w1zard999/Gyrobot/docs/SESSION-CONTEXT-2026-09-28.md

# Контекст сессии 2026-09-28 — схема Tumbller (для продолжения)

Читать вместе с STATUS.md (раздел «Сессия 2026-09-28»).

## Состояние
- Скетч: `firmware/gyrobot_tumbller/gyrobot_tumbller.ino` — стоит, ездит W/S,
  поворачивает A/D по кругу. Все подобранные значения — дефолты в прошивке.
- `firmware/gyrobot_mov` — старый, для отката (не менялся).
- Плата прошита коммитом 835385b (все дефолты в коде = в плате).

## Как работать
- Прошивка: вынуть HC-05, USB → COM10,
  `arduino-cli upload -p COM10 -b arduino:avr:nano firmware/gyrobot_tumbller`.
- После включения: положить на бок, ждать рывка колёс (калибровка ~15–20 с).
- Живые параметры по BT: `python tools/talk.py --port COM13 --boot 0.5 --cmds "kp 20"`
  (wasd.bat при этом закрыт — один порт). BT-порт не ресетит плату.
- Логи езды: `tools/logs/wasd-*.log`, разбор поворотов — `python tools/turnstat.py tools/logs/<лог>`.

## Что можно улучшить дальше
- Лёгкая тряска стоя (±0.6°) — kd/dba подобраны, дальше только механика.
- Хранить параметры в EEPROM (сейчас только дефолты в коде).
