w1zard999/Gyrobot/docs/research/Балансирующий робот Arduino эталон.md

# Возьмите Tumbller за эталон, перестаньте изобретать

За эталон стоит взять **прошивку Elegoo Tumbller**: Arduino Nano, TB6612, 2S 7,4 В, прерывание MsTimer2 каждые 5 мс, шкала ШИМ ±255 и однобуквенные команды по Bluetooth. Железо у неё почти совпадает с нашим, а алгоритм тот же, что у Keyestudio, Yahboom, Osoyoo и у китайской методики 平衡小车之家. Регулятор состоит из трёх контуров, выходы которых просто складываются: PD по углу с D-членом от гироскопа каждые 5 мс, PI по сумме энкодеров каждые 40 мс (его «интеграл» на деле означает положение колёс) и поворот через дифференциальную добавку с демпфированием по гироскопу Z. Езду никто не делает сырым ШИМ. Все задают её сдвигом цели внутри интеграла скоростного контура. Дрейф нуля никто не лечит адаптивной уставкой. Ноль угла фиксирован, а смещение центра масс выбирает тот же энкодерный интеграл. Три проблемы нашей прошивки (дрожь, уползающий ноль после повторного взвода, рывок при W/S) растут из двух отклонений от этого шаблона: «адаптивный ноль» играет роль второго интегратора на ту же ошибку, а ШИМ, добавленный в обход угла, угловой PID воспринимает как возмущение. Balanduino остаётся лучшим DIY-образцом с каскадом «скорость → целевой угол», и математически это та же схема. Но его константы привязаны к драйверам VNH5180 на 20 кГц, выходу в процентах и циклу без фиксированного периода, поэтому переносить их дороже. В конце отчёта дана готовая структура кода и стартовые коэффициенты, пересчитанные под 495 имп/об, колесо 63 мм и ШИМ ±255. Все пересчитанные числа там помечены как оценки.

## Все четыре набора прошиты одним трёхконтурным шаблоном

Исходники Tumbller, Keyestudio KS0193, Yahboom BST-ABC и Osoyoo были прочитаны напрямую, и устроены они одинаково. В ISR на 5 мс считается **угловой PD в градусах и °/с**. Раз в 8 тиков (40 мс; у Osoyoo раз в 10) работает **PI по сумме импульсов обоих колёс**: скорость проходит через фильтр 0,7/0,3, интеграл ограничен ±3000 (±3550 у Keyestudio). Результат складывается в `PWM = ±угол − скорость ∓ поворот` и обрезается до ±255 ([Elegoo BalanceCar.h](https://github.com/elegooofficial/ELEGOO-TumbllerV1.1-Self-Balancing-Car-Tutorial); [Keyestudio](https://github.com/keyestudio/KS0193-Self-balancing-Car-Kit); [Yahboom](https://github.com/YahboomTechnology/Arduino-Balance-Car)). Osoyoo ничем не отличается от Yahboom: те же вызовы `speedpiout / turnspin` и тот же протокол `$...#` ([Osoyoo](https://osoyoo.com/wp-content/uploads/2018/03/osoyoo_abc.zip)). Оригинал 平衡小车之家 на STM32 делает то же самое на своей шкале: `Moto1 = Balance + Velocity − Turn`, `Moto2 = Balance + Velocity + Turn`, угол каждые 5 мс, управление каждые 10 мс ([minibalance control.c](https://github.com/zycczy/minibalance/blob/master/MiniBalance/CONTROL/control.c)). Arduino-порт этого кода от jfboy использует MsTimer2, 5 мс для угла, 40 мс для скорости и 20 мс для поворота ([jfboy balance_car_2.0.ino](https://github.com/jfboy/BalanceCar/blob/master/balance_car_2.0.ino)).

Скоростной контур Tumbller стоит привести дословно, потому что именно его мы и берём:

```c
if (++speed_control_period_count >= 8) {           // 40 мс
  double car_speed = (enc_left + enc_right) * 0.5;  // среднее по колёсам, имп/40 мс
  enc_left = enc_right = 0;
  speed_filter = speed_filter_old * 0.7 + car_speed * 0.3;
  speed_filter_old = speed_filter;
  car_speed_integeral += speed_filter;
  car_speed_integeral += -setting_car_speed;         // команда езды — внутрь интеграла
  car_speed_integeral = constrain(car_speed_integeral, -3000, 3000);
  speed_control_output = -kp_speed * speed_filter - ki_speed * car_speed_integeral;
  rotation_control_output = setting_turn_speed + kd_turn * Gyro_z;
}
pwm_left  = balance_control_output - speed_control_output - rotation_control_output;
pwm_right = balance_control_output - speed_control_output + rotation_control_output;
```

Код взят из [Elegoo BalanceCar.h](https://github.com/elegooofficial/ELEGOO-TumbllerV1.1-Self-Balancing-Car-Tutorial). После раскрытия знаков получается `PWM = kp·θ + kd·ω + kp_s·v + ki_s·Σ(v − v_set)`. **Скоростные члены входят с тем же знаком, что и член наклона.** Это знаменитая «положительная обратная связь по скорости». В исходнике STM32 прямо написано, что скоростная обратная связь положительная: чтобы замедлиться на скорости, машинка сначала должна поехать ещё быстрее ([control.c](https://github.com/zycczy/minibalance/blob/master/MiniBalance/CONTROL/control.c)). На Zhihu это объясняют через каскад: выход скоростного контура служит целевым углом для углового, и после подстановки одного уравнения в другое внешний контур приобретает «положительный» знак ([知乎 p/206522126](https://zhuanlan.zhihu.com/p/206522126)). Значит, китайская параллельная схема и каскад Balanduino, где скорость задаёт целевой угол, — одно и то же. Параллельная форма просто вынесла деление на Kp угла в сами коэффициенты.

Коэффициенты наборов выражены в одних единицах: ШИМ на градус и ШИМ на °/с при шкале ±255.

| Набор | kp угла | kd угла | kp скорости | ki скорости | поворот | питание |
|---|---|---|---|---|---|---|
| Tumbller | 55 | 0,75 | 10 | 0,26 | kd_turn 0,5 (kp_turn 2,5 не используется) | 2S 7,4 В, 1:30 |
| Keyestudio | 34 | 0,62 | 3,6 | 0,080 | kp 24, kd 0,08 | 3×18650, 12 В |
| Yahboom | 38 | 0,58 | 3,8 | 0,11 | kp 28, kd 0,29 | 3×18650 |
| Osoyoo | 40 | 0,6 | 5,2 | 0,25 | kp 23, kd 0,3 | 3×18650 |

Источники таблицы: [Elegoo](https://github.com/elegooofficial/ELEGOO-TumbllerV1.1-Self-Balancing-Car-Tutorial), [Keyestudio](https://github.com/keyestudio/KS0193-Self-balancing-Car-Kit), [Yahboom](https://github.com/YahboomTechnology/Arduino-Balance-Car), [Osoyoo](https://osoyoo.com/wp-content/uploads/2018/03/osoyoo_abc.zip). По железу **Tumbller ближе всех к нам**: два ICR18650, моторы 1:30 с датчиком Холла на 22 импульса за оборот мотора (660 на оборот колеса), колесо около 67 мм. Эти данные взяты из стороннего блога и только из поисковых сниппетов ([Tom Wilson, Medium](https://medium.com/@tomw3115/programming-the-elegoo-tumbller-self-balancing-robot-part-2-e9ab09c6bea2)). Остальные три набора работают от 12 В. У Tumbller есть и слабые места, которые мы не копируем. Направление энкодера он берёт из знака последнего ШИМ, а не из квадратуры. В D-член подаёт сырой гироскоп с зашитым смещением 128,1 LSB, а не скорость, очищенную фильтром Калмана от смещения. `Gyro_z = -gz / 131` у него считается целочисленным делением. Наконец, в скоростном цикле нет никакой рампы ([Elegoo BalanceCar.h / KalmanFilter.cpp](https://github.com/elegooofficial/ELEGOO-TumbllerV1.1-Self-Balancing-Car-Tutorial)). Keyestudio берёт для D-члена очищенную скорость `angle_speed = gyro_m − q_bias`, и это правильный вариант ([Keyestudio](https://github.com/keyestudio/KS0193-Self-balancing-Car-Kit)).

## Езда идёт через интеграл положения, а не через сырой ШИМ

**Ни один проверенный проект не добавляет «ШИМ езды» в обход углового контура.** Tumbller каждые 40 мс вычитает `setting_car_speed` из интеграла: 80 в режиме Bluetooth, 40 по умолчанию, 20 в режиме следования. Поэтому в установившемся режиме отфильтрованная скорость равна этой цели в импульсах за 40 мс ([Elegoo Tumbller.ino](https://github.com/elegooofficial/ELEGOO-TumbllerV1.1-Self-Balancing-Car-Tutorial)). Для колеса Tumbller 80 имп/40 мс соответствуют примерно 0,6 м/с. Keyestudio и Yahboom на каждом тике прибавляют к `positions` ±250 (в другой ревизии Yahboom ±700) ([Keyestudio](https://github.com/keyestudio/KS0193-Self-balancing-Car-Kit); [Yahboom mirror](https://github.com/GaloisInc/lean4-balance-car/blob/main/ArduinoBalanceCar/ArduinoBalanceCar.ino)). Оригинал STM32 делает `Encoder_Integral -= Movement`. Максимальную скорость там ограничивает ограничение интеграла, а комментарий в jfboy так и называет его: «积分限,控制最高速度» ([control.c](https://github.com/zycczy/minibalance/blob/master/MiniBalance/CONTROL/control.c); [jfboy](https://github.com/jfboy/BalanceCar/blob/master/balance_car_2.0.ino)). Разбор на CSDN объясняет, почему цель задают через интеграл, а не через ошибку скорости. Прямая уставка скорости слишком сильно мешает удержанию вертикали и на практике работает нестабильно. Смещение положения меняется медленно и на вертикаль почти не влияет. Итоговый вывод автора: «控制速度的本质就是改变倾角», то есть управлять скоростью значит менять наклон ([CSDN 54572569](https://blog.csdn.net/zhaoyuaiweide/article/details/54572569)).

Этим объясняется наш рывок. Если прибавить к выходу ШИМ, не сдвинув цель, угловой PID увидит возмущение и сначала погасит его толчком в обратную сторону, и только потом робот наклонится. В схеме с интегралом порядок обратный и физически правильный. Интеграл уходит в минус, колёса на мгновение откатываются назад, корпус наклоняется вперёд, и дальше угловой контур сам разгоняет робот. Так ведёт себя неминимально-фазовая система. Balanduino добивается того же явным путём. Команда пульта сдвигает уставку угла не больше чем на `controlAngleLimit = 7°`, а сама уставка меняется не быстрее чем на **1° за итерацию** (`constrain(restAngle, lastRestAngle − 1, lastRestAngle + 1)`) ([Motor.ino](https://github.com/TKJElectronics/Balanduino/blob/master/Firmware/Balanduino/Motor.ino); [EEPROM.ino](https://github.com/TKJElectronics/Balanduino/blob/master/Firmware/Balanduino/EEPROM.ino)). У Tumbller рампы нет, цель меняется ступенькой. Сглаживает её только фильтр 0,7/0,3 и сам интегратор. Поэтому рампу цели мы добавим сами, по примеру Balanduino.

Поворот везде сделан дифференциальной добавкой: одному колесу она прибавляется, у другого вычитается. У Tumbller это `setting_turn_speed + kd_turn·Gyro_z`, где setting равен ±80 ШИМ в режиме Bluetooth, а kd_turn 0,5 ([Elegoo](https://github.com/elegooofficial/ELEGOO-TumbllerV1.1-Self-Balancing-Car-Tutorial)). Если переписать выражение как `kd_turn·(ω_цель − ω_z)`, видно, что это П-регулятор угловой скорости рыскания с целью 80/0,5 = 160 °/с. Такая запись удобнее для нас. Keyestudio, Yahboom и STM32 не прыгают сразу на полную цель поворота. Пока клавиша держится, они наращивают её с шагом, который зависит от текущей скорости (`Turn_Convert = 50/|сумма энкодеров|`, от 0,6 до 3), а при отпускании сбрасывают в ноль ([control.c turn()](https://github.com/zycczy/minibalance/blob/master/MiniBalance/CONTROL/control.c); [Yahboom](https://github.com/YahboomTechnology/Arduino-Balance-Car)). В режиме Bluetooth Tumbller разрешает ехать и поворачивать одновременно. STM32 такое сочетание запрещает. Автоматического отпускания команд по таймауту нет ни в одном из кодов: Yahboom полагается на явный символ «стоп», у Tumbller это `s` ([Yahboom mirror](https://github.com/GaloisInc/lean4-balance-car/blob/main/ArduinoBalanceCar/ArduinoBalanceCar.ino); [Elegoo Command.h](https://github.com/elegooofficial/ELEGOO-TumbllerV1.1-Self-Balancing-Car-Tutorial)). Наш ПК-клиент при отпускании клавиши просто перестаёт слать буквы, поэтому таймаут придётся добавить самим.

## Дрейф нуля убирает энкодерный интеграл, а не адаптивная уставка

Во всех наборах **ноль угла — константа**: `angle_zero = 0` у Tumbller, `angle0 = 0` у Yahboom и Osoyoo, 0 или 1 у Keyestudio. Во время работы его никто не подстраивает. Исключение одно: скетч 12 Keyestudio позволяет задать ноль вручную с телефона ([Elegoo](https://github.com/elegooofficial/ELEGOO-TumbllerV1.1-Self-Balancing-Car-Tutorial); [Keyestudio](https://github.com/keyestudio/KS0193-Self-balancing-Car-Kit)). Смещение центра масс выбирает интеграл скоростного контура. В установившемся режиме робот стоит под таким наклоном, при котором `Kp·(θ − ноль) + Ki·x = 0`. Ошибка нуля на Δ градусов лишь сдвигает точку стоянки на `Kp·Δ/Ki` импульсов, для STM32 это 300·1/0,4 = 750. Это наш вывод из формул [control.c](https://github.com/zycczy/minibalance/blob/master/MiniBalance/CONTROL/control.c). В оригинале STM32 есть даже режим «斜坡悬停» (удержание на склоне), где это сделано явно: `Zhongzhi = −Encoder/10 − Encoder_Integral/300`. Уставка там движется **по состоянию энкодеров, а не по выходу PID** ([control.c](https://github.com/zycczy/minibalance/blob/master/MiniBalance/CONTROL/control.c)). Balanduino поступает так же. В режиме стоянки уставка угла корректируется по ошибке положения колёс по четырём зонам и по их скорости, ограничена ±10° от номинала, а точка удержания запоминается, только когда `|wheelVelocity| ≤ 40` ([Motor.ino](https://github.com/TKJElectronics/Balanduino/blob/master/Firmware/Balanduino/Motor.ino); [Balanduino.ino](https://github.com/TKJElectronics/Balanduino/blob/master/Firmware/Balanduino/Balanduino.ino)).

«Адаптивный ноль по выходу PID» пришёл из робота YABR на шаговых моторах. Там уставка сдвигается на ±0,0015 за цикл 4 мс, и только при отпущенном пульте ([yabr](https://github.com/siredmar/yabr/blob/master/Balancing_robot_ownPID/Balancing_robot_ownPID.ino)). У шаговика выход PID и есть скорость колёс, поэтому средний ненулевой выход действительно значит «уезжаю». У DC-мотора выход означает напряжение, то есть момент. Средний ненулевой ШИМ может давать трение, мёртвая зона, разница моторов или просевшая батарея, так что адаптация исправляет не ту причину. У нас она вдобавок образует второй интегратор на ту же ошибку, не согласованный с первым, и накопленный сдвиг сохраняется после повторного взвода. Всё это наш вывод, но он точно описывает наблюдаемые симптомы. Прямого сравнения двух подходов на DC-роботах в источниках найти не удалось.

Защита от падения во всех кодах одинакова: при большом наклоне моторы отключаются и сбрасываются интеграторы. Tumbller отключается за пределами ±22°, в STOP обнуляет `car_speed_integeral` и цель скорости, а при старте ждёт 2 с, проверяет, что угол в пределах ±22°, и снова всё обнуляет ([Elegoo BalanceCar.h / Tumbller.ino](https://github.com/elegooofficial/ELEGOO-TumbllerV1.1-Self-Balancing-Car-Tutorial)). Порог у Yahboom ±30°, у STM32 ±40° ([Yahboom](https://github.com/YahboomTechnology/Arduino-Balance-Car); [control.c](https://github.com/zycczy/minibalance/blob/master/MiniBalance/CONTROL/control.c)). STM32 обнуляет интеграл всякий раз, когда моторы выключены: «电机关闭后清除积分». В нём же есть детектор подъёма робота в три этапа (покой, всплеск ускорения по Z у вертикали, разгон колёс) и детектор постановки на пол. Balanduino через `stopAndReset()` обнуляет iTerm и lastError, запоминает `targetPosition` и возвращает уставку к номиналу ([Motor.ino](https://github.com/TKJElectronics/Balanduino/blob/master/Firmware/Balanduino/Motor.ino)). Мягкого старта с плавным нарастанием коэффициентов после взвода нет ни в одном источнике.

## Цикл 5 мс, гироскоп ±250 °/с и медленный внешний контур

Частота у всех близкая. Arduino-наборы и jfboy используют ISR MsTimer2 на 5 мс, который начинается с `sei()`, чтобы внутри могли срабатывать прерывания энкодеров. В этой же ISR выполняются чтение I2C, фильтр, PD и запись в моторы ([Elegoo](https://github.com/elegooofficial/ELEGOO-TumbllerV1.1-Self-Balancing-Car-Tutorial); [jfboy](https://github.com/jfboy/BalanceCar/blob/master/balance_car_2.0.ino)). YABR держит жёсткие 4 мс по `micros()` и настраивает MPU на ±250 °/с с DLPF 0x03 ([yabr](https://github.com/siredmar/yabr/blob/master/Balancing_robot_ownPID/Balancing_robot_ownPID.ino)). У Balanduino та же настройка: ±250 °/с, `0x03 // 44 Hz Acc filtering, 42 Hz Gyro filtering`. Цикл у него работает без фиксированного периода с измерением dt, а смещение гироскопа калибруется на старте по 25 выборкам с проверкой неподвижности ([Balanduino.ino](https://github.com/TKJElectronics/Balanduino/blob/master/Firmware/Balanduino/Balanduino.ino); [Tools.ino](https://github.com/TKJElectronics/Balanduino/blob/master/Firmware/Balanduino/Tools.ino)). Сами наборы DLPF не настраивают и полагаются на значения библиотеки по умолчанию. Задержка гироскопа при DLPF 3 составляет около 4,8 мс, при DLPF 2 около 2,8 мс, при DLPF 4 около 8,3 мс. Эти цифры взяты из карты регистров MPU-6000/6050, регистр 26, и их нужно сверить с PDF ([Register Map](https://invensense.tdk.com/wp-content/uploads/2015/02/MPU-6000-Register-Map1.pdf)).

Тип фильтра вторичен. Tumbller, Keyestudio и Yahboom используют один и тот же скалярный фильтр Калмана (`Q_angle 0.001, Q_gyro 0.005, R_angle 0.5, dt 0.005`, угол `atan2(ay, az)`). В STM32 можно выбрать DMP, Калмана или комплементарный фильтр с `K1 = 0.02`, и авторы пишут, что «все три хорошо настроены» ([filter.c](https://github.com/zycczy/minibalance/blob/master/MiniBalance/filter/filter.c); [control.c](https://github.com/zycczy/minibalance/blob/master/MiniBalance/CONTROL/control.c)). Комплементарный фильтр с K1 = 0,02 при шаге 5 мс имеет постоянную времени около 0,25 с (наш пересчёт). Скорость фильтруется так: у Tumbller 0,7/0,3 на тик 40 мс, что по нашему расчёту даёт постоянную около 110 мс; у STM32 0,8/0,2 на тик 10 мс. Цель китайские авторы формулируют прямо: «平衡为主，其他为辅», то есть главное — удержание вертикали, остальное вторично, и скоростной контур нельзя пускать в ту же полосу частот ([知乎 p/206522126](https://zhuanlan.zhihu.com/p/206522126)). B-robot идёт дальше и вычитает из скорости колёс вклад качания корпуса, `estimated_speed = −actual_robot_speed + angular_velocity`, после чего фильтрует 0,9/0,1 ([BROBOT_EVO2.ino](https://github.com/jjrobots/B-ROBOT_EVO2/blob/master/Arduino/BROBOT_EVO2/BROBOT_EVO2.ino)).

Две особенности нашего робота делают тайминг строже, чем у наборов. Первая — низкий центр масс. Неустойчивый полюс 19 рад/с соответствует эффективной длине маятника около 27 мм. Проверенные проекты, наоборот, поднимают массу: в EduBal батарею «purposely placed high above the ground … to raise the center of mass» ([arXiv 2005.09304](https://arxiv.org/pdf/2005.09304)). Для маятника темп расхождения равен √(g/ℓ) ([Wikipedia](https://en.wikipedia.org/wiki/Inverted_pendulum)). По нашей оценке, если поднять ℓ до 60–100 мм, полюс снизится до 10–13 рад/с, а время удвоения наклона вырастет с 36 до 54–70 мс. Вторая — люфт редуктора. EduBal прямо называет его главной причиной остаточных колебаний и ради этого вводит внутренний PI по скорости колеса ([arXiv 2005.09304](https://arxiv.org/pdf/2005.09304)). Против люфта и мёртвой зоны помогают меньший Kp, более сильный D-член от гироскопа, а также небольшая компенсация мёртвой зоны (MIN_ABS_SPEED 30 у Franko) или зона нечувствительности выхода ±5 у YABR ([Franko](https://github.com/lukagabric/Franko); [yabr](https://github.com/siredmar/yabr/blob/master/Balancing_robot_ownPID/Balancing_robot_ownPID.ino)). В Balanduino компенсации мёртвой зоны нет вообще ([Motor.ino](https://github.com/TKJElectronics/Balanduino/blob/master/Firmware/Balanduino/Motor.ino)).

## Адаптация: Tumbller на нашем Nano, шаг за шагом

### Почему Tumbller, а не Balanduino или STM32-оригинал

Tumbller выигрывает, потому что совпадает с нами по всему, что определяет масштаб коэффициентов. Это тот же ATmega328P, тот же TB6612, те же 2S 7,4 В, та же шкала ±255, тот же MsTimer2 на Timer2 (он у нас свободен) и тот же однобуквенный протокол. Его kp и kd в ШИМ/° и ШИМ/(°/с) переносятся без смены единиц. Balanduino — хороший и открытый образец с каскадом через угол, но у него выход в процентах, ШИМ 20 кГц на VNH5180, цикл без фиксированного периода и восемь зонных констант положения, привязанных к 928 имп/об ([Balanduino.h](https://github.com/TKJElectronics/Balanduino/blob/master/Firmware/Balanduino/Balanduino.h)). Каждую пришлось бы пересчитывать. STM32-оригинал работает на шкале 8400 с сырым гироскопом ±2000 °/с. Его стоит брать как справочник по методике настройки, а не как код для переноса. Из остальных источников мы берём четыре доработки. От Keyestudio и Balanduino — очищенную от смещения скорость гироскопа в D-член. От Balanduino — рампу цели движения. От STM32 — сброс интеграла при любом отключении моторов. Своё добавляем квадратурное направление энкодера и таймаут клавиш. Адаптивный ноль, фазовый гейт и инжекцию сырого ШИМ из текущей прошивки нужно **удалить полностью**.

### Структура цикла и формулы со знаками

Знаки условимся считать так. θ > 0 означает наклон вперёд, ω = dθ/dt в °/с. ШИМ > 0 крутит колесо вперёд. Импульсы энкодеров со знаками esA = +1 и esB = −1 положительны при движении вперёд. Скорость рыскания r > 0 означает поворот влево, против часовой стрелки при взгляде сверху. При оси Z вверх это знак gz, но его нужно проверить на шаге 8 ниже. Период 5 мс задаёт MsTimer2. Надёжнее, чтобы ISR только ставила флаг, а весь расчёт шёл в `loop()` по этому флагу. Дело в том, что Wire с таймаутом `setWireTimeout(25000, true)`, спасающий нашу шину от помех моторов, и Serial в ISR ведут себя хуже. Tumbller считает прямо в ISR после `sei()`. Это рабочий вариант, но в нём таймаут I2C на 25 мс ломает период. Отход от эталона здесь наш и сознательный.

```c
// ---- 5 мс тик ----
void controlTick() {
  if (!mpuRead()) return;                              // 14 байт с 0x3B, timeout как сейчас
  float rate   = (GyX - gxOff) / 131.0f;               // °/с, gxOff калибруется на старте
  float yawR   = (GyZ - gzOff) / 131.0f;               // °/с, знак проверить (шаг 8)
  float accAng = atan2(AcY - ABY, AcZ - ABZ) * 57.296f; // как в текущем imu.h
  angle = 0.98f * (angle + rate * 0.005f) + 0.02f * accAng;   // K1=0.02 (minibalance)

  if (!armed) { motorsCoast(); tryArm(); return; }
  if (fabs(angle - ANGLE_ZERO) > FALL_DEG) { disarm(); return; }

  float balance = KP * (angle - ANGLE_ZERO) + KD * rate;      // PD, D от гироскопа

  if (++spdCnt >= 8) {                                  // 40 мс
    spdCnt = 0;
    noInterrupts(); int cL = encL; int cR = encR; encL = encR = 0; interrupts();
    float v = (cL + cR) * 0.5f;                         // имп/40 мс, среднее колёс, + вперёд
    vF = 0.7f * vF + 0.3f * v;                          // фильтр Tumbller
    updateKeysAndRamps();                               // moveSet, turnSet (см. ниже)
    posI += vF - moveSet;                               // интеграл = положение минус цель
    posI = constrain(posI, -I_LIM, I_LIM);
    speedOut = KP_S * vF + KI_S * posI;                 // тот же знак, что у balance
  }
  float turn = KD_T * (turnSet - yawR);                 // П по скорости рыскания
  float uL = balance + speedOut - turn;                 // левое = мотор A
  float uR = balance + speedOut + turn;                 // turn>0 → правое быстрее → влево
  motorOut(A, uL, DB_A);  motorOut(B, uR, DB_B);        // +sign(u)*DB, clamp ±255
}
```

`disarm()` отключает моторы (STBY = LOW или все IN в 0). `tryArm()` взводит робот, когда |θ − ANGLE_ZERO| < 5° непрерывно 300 мс. И взвод, и падение обнуляют одно и то же: `posI`, `vF`, `speedOut`, `moveSet`, `turnSet`, счётчики энкодеров и состояние клавиш. `ANGLE_ZERO` во время работы **не меняется никогда**. Прерывания энкодеров остаются как есть: RISING на A, направление по B в ISR. Это настоящая квадратура, в отличие от Tumbller, где направление угадывается по знаку ШИМ именно там, где балансирующий робот проводит всё время, около нуля. При желании можно считать CHANGE на A и определять направление по равенству A и B, как в jfboy «二倍频» ([jfboy](https://github.com/jfboy/BalanceCar/blob/master/balance_car_2.0.ino)). Это даст 990 имп/об и вдвое меньший шум квантования скорости, но тогда KP_S, KI_S и MOVE нужно поделить на 2, а I_LIM умножить на 2.

### WASD: цели, рампы и таймаут

В `loop()` каждый принятый байт `w/s/a/d` обновляет свою метку `tW/tS/tA/tD = millis()`. Клиент шлёт буквы с частотой 10 Гц, поэтому клавиша считается нажатой, пока её метка моложе **250 мс**, то есть 2,5 периода. Раз в 40 мс `updateKeysAndRamps()` вычисляет направление `fwd = (W нажата) − (S нажата)` и цель `moveTgt = fwd·MOVE`. Затем `moveSet` подтягивается к этой цели не быстрее чем на 2 имп/40 мс при разгоне и на 3 имп/40 мс при торможении. Цель поворота `turnTgt = ((A) − (D))·YAW_MAX` в °/с. `turnSet` растёт к ней на 15 °/с за тик, а при отпускании клавиши, как в STM32 и Yahboom, сразу сбрасывается в 0. Дальше робот тормозит вращение сам через член `−KD_T·yawR`. Езда и поворот складываются, как в режиме Bluetooth у Tumbller. Рампа выбрана из физики, это наш расчёт. Каждый тик прибавляет к цели 2 имп/40 мс = 50 имп/с ≈ 0,02 м/с. За 40 мс это ускорение около 0,5 м/с², и оно ведёт к установившемуся наклону atan(0,5/9,81) ≈ 3°. Это в пределах 7°, которые Balanduino разрешает пульту. Если после отпускания W робот катится дальше слишком долго, можно добавить трюк из jfboy: при нулевой команде стравливать интеграл к нулю на 200 за тик, если |интеграл| > 300. Масштаб этих чисел нужно подобрать заново ([jfboy](https://github.com/jfboy/BalanceCar/blob/master/balance_car_2.0.ino)).

### Стартовые коэффициенты, пересчитанные под наше железо

Пересчёт основан на отношении разрешений. У Tumbller 660 имп на π·67 мм ≈ 3,14 имп/мм, у нас 495 на π·63 мм ≈ 2,50 имп/мм, отношение 0,80. Скоростные коэффициенты привязаны к импульсам, поэтому их нужно умножить на 1,25, а ограничение интеграла и цель движения — на 0,80. Шкала ШИМ и периоды совпадают. Отношение kp_s/kp угла имеет физический смысл: это «градусы целевого наклона на единицу скорости». Нужный для ускорения наклон, a = g·tanθ, не зависит от высоты центра масс, поэтому переносить надо именно это отношение, а не абсолютное значение kp_s. У Tumbller оно равно 10/55 ≈ 2,3° на 100 мм/с и 0,26/55 ≈ 1,5° на 100 мм ошибки положения. В наших импульсах получается **KP_S ≈ 0,228·KP** и **KI_S ≈ 0,0059·KP**. Для сверки: в Tumbller ki/kp скорости равно 1/38 при тике 40 мс, а китайское правило Ki = Kp/200 при тике 10 мс в реальном времени соответствует 1/50 при 40 мс, то есть величине того же порядка ([CSDN 105153978](https://blog.csdn.net/best_xiaolong/article/details/105153978); [minibalance main.c](https://github.com/zycczy/minibalance/blob/master/USER/main.c)).

| Параметр | Tumbller (источник) | Наш старт | Происхождение |
|---|---|---|---|
| Период угла / скорости | 5 мс / 40 мс | 5 мс / 40 мс | из источника |
| Фильтр скорости | 0,7/0,3 | 0,7/0,3 | из источника |
| Фильтр угла | Калман Q 0,001/0,005, R 0,5 | комплементарный K1 0,02 (или Калман Tumbller) | из источника (minibalance / Tumbller) |
| MPU | ±250 °/с, DLPF не задан | ±250 °/с, DLPF 0x03 (при запасе можно 0x02) | Balanduino/YABR, выбор под наш быстрый полюс |
| KP угла, ШИМ/° | 55 | начать с 20, найти предел, умножить на 0,6; ожидается 30–50 | оценка |
| KD угла, ШИМ/(°/с) | 0,75 (сырой гироскоп) | начать с 0,4; ожидается 0,7–1,2 (нужно больше D, чем у Tumbller, из-за полюса 19 рад/с) | оценка |
| KP_S, ШИМ/(имп/40 мс) | 10 | 0,228·KP → 8,0 при KP 35; 12,5 при KP 55 | пересчёт |
| KI_S, ШИМ/имп | 0,26 | 0,0059·KP → 0,21 при KP 35; 0,33 при KP 55 | пересчёт |
| I_LIM, имп | ±3000 | ±2400 | пересчёт (×0,80) |
| Цель езды MOVE, имп/40 мс | 80 (≈0,64 м/с) | 15 (≈0,15 м/с), затем до 25 (≈0,25 м/с) | пересчёт и выбор: 1 имп/40 мс ≈ 10 мм/с |
| Рампа MOVE | нет | +2 / −3 имп/40 мс за тик | наше, по образцу лимита Balanduino 1°/итерацию |
| Поворот | 80 ШИМ + 0,5·Gyro_z → ≈160 °/с | KD_T 0,5, YAW_MAX 90 °/с, рампа 15 °/с за 40 мс | пересчёт и выбор |
| Отключение при падении | ±22° | ±25° | выбор (у наборов 22–40°) |
| Взвод | ждёт 2 с, угол в пределах ±22° | |θ − ANGLE_ZERO| < 5° в течение 300 мс, полный сброс | наше |
| Мёртвая зона | нет | DB_A 12, DB_B 9 (≈75% от измеренных 16/12) | оценка |
| Таймаут клавиши | нет (явный `s`) | 250 мс | наше |

Потолок скорости на 7,4 В мы оценили пропорционально: 210 об/мин при 6 В дают около 260 об/мин без нагрузки, то есть примерно 0,85 м/с. Цель Tumbller в 0,64 м/с для нас близка к насыщению, поэтому MOVE стоит начинать с 15. Оценки ki_s·I_LIM ≈ 500 ШИМ при KP 35 хватает, чтобы выбрать ошибку нуля в несколько градусов. При KP 35 каждый градус ошибки стоит около 170 импульсов, то есть примерно 7 см сдвига точки стоянки. Это тоже наш расчёт.

### Процедура проверки знаков и настройки

Порядок взят из китайской методики: 机械中值, затем полярность и величина Kp и Kd угла, умножение на 0,6, полярность и величина скоростного контура, поворот. В jfboy эти этапы оставлены в коде закомментированными строками: «только вертикаль», «вертикаль + скорость», «три контура» ([CSDN 113786386](https://blog.csdn.net/weixin_44270218/article/details/113786386); [CSDN 105153978](https://blog.csdn.net/best_xiaolong/article/details/105153978); [jfboy](https://github.com/jfboy/BalanceCar/blob/master/balance_car_2.0.ino)). Каждый шаг ниже меняет только одну величину.

| Шаг | Что включено | Действие | Правильно | Если нет |
|---|---|---|---|---|
| 0 | моторы выключены | Медленно наклонять робот рукой вперёд и назад до точки опрокидывания, записать оба угла | ANGLE_ZERO = середина между ними (пример из источника: 2° и −3° → −1°) | — |
| 1 | только моторы | Подать +60 ШИМ на A, потом на B | колесо едет вперёд, его счётчик растёт | поменять AIN1/AIN2 (BIN1/BIN2) или знак es |
| 2 | только IMU | Наклонить робот вперёд | angle растёт, rate > 0 | сменить знак atan2 или гироскопа |
| 3 | KP = 20, всё остальное 0 | Держа робот, наклонить его вперёд | колёса едут вперёд, «под падение» | сменить знак KP |
| 4 | KD = 0,4, KP = 0 | Поднять робот, быстро качнуть корпус вперёд вокруг оси | колёса крутятся вперёд, «следуют» за корпусом | сменить знак KD |
| 5 | KP и KD | Поднимать KP до крупных низкочастотных колебаний, затем KD до высокочастотного дребезга; оба умножить на 0,6 | стоит несколько секунд, потом уползает; это нормально | — |
| 6 | KP_S = 8, KI_S = 0, KP = KD = 0 | Поднять робот, провернуть одно колесо вперёд рукой | оба колеса разгоняются вперёд (положительная обратная связь) | сменить знак скоростного члена |
| 7 | все контуры, KI_S = 0,0059·KP | Поставить на пол, толкнуть | стоит на месте и возвращается на точку; мало → уезжает через 1–2 с, много → раскачка с большим наклоном | KP_S и KI_S вместе, методом бисекции |
| 8 | KD_T = 0,5 | Поднять робот, повернуть его вокруг вертикали влево | колёса создают момент против поворота | сменить знак yawR |
| 9 | всё | Нажать W | короткий откат назад, наклон вперёд, плавная езда; после отпускания остановка без раскачки | уменьшить рампу или MOVE |

Критерии для шагов 3–7 взяты из источников: [CSDN 105153978](https://blog.csdn.net/best_xiaolong/article/details/105153978), [CSDN 113786386](https://blog.csdn.net/weixin_44270218/article/details/113786386), [CSDN 54572569](https://blog.csdn.net/zhaoyuaiweide/article/details/54572569). По правилу «умножить на 0,6» китайские авторы пишут, что по инженерному опыту идеальные параметры равны максимальным, умноженным на 0,6. Сразу после этого робот стоит хуже, пока не включён скоростной контур ([CSDN 113786386](https://blog.csdn.net/weixin_44270218/article/details/113786386)). Если на шаге 5 дрожь не уходит ни при каком KD, вероятная причина — люфт при низком центре масс. Тогда в первую очередь стоит уменьшить KP и поднять батарею, а подкручивать мёртвую зону — потом.

## Conclusion

Главный вывод: проблема была не в неудачных коэффициентах, а в том, куда подаются управляющие сигналы. Оба наших изобретения, адаптивный ноль и инжекция ШИМ с фазовым гейтом, пытались сделать то, что в проверенной схеме делает одна переменная: интеграл положения колёс внутри скоростного контура. Через неё проходят и компенсация центра масс, и команда езды, и ограничение скорости. Когда все три задачи сводятся в эту переменную, из прошивки исчезают и второй интегратор, и конфликт с угловым контуром. Сброс этой переменной при взводе устраняет «уползший ноль».

Всё, что осталось подобрать, — это KP и KD угла. Они зависят от нашего быстрого полюса и люфта, поэтому из источников их не взять. Скоростные коэффициенты после этого вычисляются по отношению к KP, а не подбираются заново. Самое дешёвое усиление всей схемы механическое: подъём батареи на 5–10 см замедляет полюс примерно в 1,5–2 раза. Это даёт больше запаса, чем любая замена фильтра или частоты цикла.
