w1zard999/Gyrobot/docs/STATUS.md

# Гиробот — журнал проекта

> Актуальная инструкция — `README.md` в корне. Здесь подробная история поисков,
> замеров и настройки по сессиям; старые разделы описывают прошивки, которых
> в репозитории больше нет (gyrobot_mov, v5 — см. историю git).

Обновляется по ходу работы. Не переделывать то, что уже отмечено сделанным.

## Железо (из schema.png, EasyEDA, rev 1.0)

- MCU: Arduino Nano (ATmega328P)
- IMU: MPU-6050 (I2C)
- Драйвер моторов: TB6612FNG
- Bluetooth: HC-05 — **физически отключён**, разведён на аппаратный UART (D0/D1)
- Клеммники: JP3 = питание (батарея), JP2 = мотор A, JP1 = мотор B

## Распиновка — РЕАЛЬНАЯ, снята прозвонкой на живой плате

**schema.png НЕ соответствует собранной плате. Верить только этой таблице.**
Найдено перебором пинов с обратной связью по энкодерам (2026-09-07).

| Nano | Куда | Проверено |
|---|---|---|
| D9  | TB6612 PWMA | мотор A крутится в обе стороны |
| D7  | TB6612 AIN1 | + направление |
| D8  | TB6612 AIN2 | − направление |
| D10 | TB6612 PWMB | мотор B крутится в обе стороны |
| D5  | TB6612 BIN1 | + направление |
| D4  | TB6612 BIN2 | − направление |
| D6  | TB6612 STBY | HIGH = драйвер включён |
| A4  | MPU6050 SDA | I2C работает |
| A5  | MPU6050 SCL | I2C работает |
| D2  | энкодер A, канал A | INT0 |
| A2  | энкодер A, канал B | направление |
| D3  | энкодер B, канал A | INT1 |
| A3  | энкодер B, канал B | направление |
| D0/D1 | HC-05 TXD/RXD | модуль снят, конфликт с USB |

**Мотор A = ЛЕВОЕ колесо, мотор B = ПРАВОЕ.**
Знаки энкодеров: команда `t a +` даёт totA отрицательный → `esA = -1`, `esB = +1`.

Свободны: D11, D12, D13, A0, A1.

### Чем схема врала
Схема показывала PWMA на D4/D11, AIN1 на D5, BIN1/BIN2 на D7/D8 — всё это неверно.
Не тратить время на трассировку schema.png, она устарела относительно сборки.

### Как искать пин, если что-то снова не сойдётся
1. `io <пин> <0|1>` — ручное управление любым пином
2. Держать ШИМ-пин канала в HIGH, по очереди поднимать пины-кандидаты
3. Смотреть `n` (накопительные totA/totB) — сотни импульсов = нашёлся пин направления
У TB6612 короткое замыкание обмотки (тугое колесо) возникает и при IN1=IN2=H,
и при PWM=LOW независимо от IN. Поэтому «тугое колесо» = «ШИМ не приходит».
Проверка механики: `io 6 0` (STBY=LOW) — оба выхода в высокое сопротивление,
оба колеса обязаны стать свободными.

## Железо: ответы пользователя (2026-09-07)

- Питание JP3: 2S Li-ion/LiPo ~7.4В → maxpwm по умолчанию 200 (≈5.8В на мотор)
- Энкодеры ЕСТЬ, подключены к **D2, D3, A2, A3** (на schema.png их нет — разведены отдельно).
  Принято: D2 = мотор A канал A (INT0), A2 = мотор A канал B; D3 = мотор B канал A (INT1), A3 = канал B.
  Если моторы/энкодеры перепутаны — правится параметрами esA/esB (знак) без перепайки.
- Задача: стоять + ездить по командам (`d <speed> <turn>`)

## Инструменты (в tools/)

| Что | Как |
|-----|-----|
| Прошить | `tools/flash.sh` — сам гасит демон, компилит, заливает, поднимает демон |
| Послать команду | `tools/say.sh "kp 20" "w"` (можно `-t 5` — слушать 5 сек) |
| Демон порта | `tools/serd.py` — держит порт открытым, чтобы Nano НЕ ресетился между командами |
| Лог | `tools/.serd.log` (весь поток), FIFO команд `tools/.serd.cmd` |
| Разовый коннект | `tools/ser.py -t 2 -q` — ресетит плату при открытии, для тюнинга не годится |

Порт: `/dev/cu.usbserial-21210`, 115200. Загрузка падает с
"unable to open port", если демон жив → всегда через `tools/flash.sh`.

## Протокол (Serial, он же будущий Bluetooth)

Телеметрия 20 Гц: `a=<угол> r=<гироскоп,°/с> sp=<скорость,энк> so=<выход конт.скорости> pA= pB= en= fall=`

Команды: `p` параметры · `<имя> <знач>` установка · `e 0/1` вкл баланс · `s 0/1` поток
`c` калибровка гироскопа (3 с неподвижно) · `z` принять текущий угол за ноль
`d <speed> <turn>` езда · `t a|b <pwm>` прогон мотора (только при `e 0`)
`n` энкодеры · `raw` сырые данные IMU + |a| · `dbg` регистры MPU
`w` сохранить в EEPROM · `l` загрузить · `f` заводские · `h` помощь

Параметры: kp kd (баланс PD) · ksp ksi (контур скорости PI) · ktp ktd (поворот)
zero (точка равновесия) · maxpwm · dead (компенсация мёртвой зоны мотора) · alpha (фильтр)
fall (угол падения) · arec (авто-возврат) · axu axf axg axt (оси IMU: ±1=X ±2=Y ±3=Z)
esA esB (знаки энкодеров) · mvA mvB (знаки моторов) · gbx gby gbz (смещение гироскопа)

## IMU: решено (2026-09-07)

Чип настоящий: WHO_AM_I=0x68, регистры в порядке. Проблема была в **смещении нуля
акселерометра**: ось Y уезжает почти на −0.9g. Из-за этого лёжа получалось |a|=0.19g.

Снял 282 замера при наклонах, вписал окружность в плоскость YZ методом наименьших
квадратов. Результат (радиус 16130 при 1g=16384, ошибка масштаба −1.5%, невязка 49 LSB):

    abx = 234    aby = -14808    abz = 426

После вычитания |a| = 0.98–0.99g в любом положении. Значения зашиты в defaults и
сохранены в EEPROM.

### Ориентация MPU (измерено, не угадано)

- **вверх = +Z** → `axu = 3`
- **вперёд = +Y** → `axf = 2` (угол растёт при наклоне вперёд)
- **ось наклона = гироскоп X** → `axg = 1` (знак совпадает с ростом угла)
- **рыскание = гироскоп Z** → `axt = 3`

Смещение гироскопа откалибровано командой `c`: gbx=1157, gby=186, gbz=93 (сохранено).
После калибровки угол лёжа держится 81.14° без дрейфа, r≈0.

## Проверка железа под аккумулятором (2026-09-07)

- **Мотор B — рабочий.** Энкодер B считает, скорость растёт с ШИМ (80/150/220).
- **Энкодер A — рабочий.** Ручная прокрутка: totA=38, totB=174.
- **Соответствие каналов и колёс (измерено торможением):**
  канал B драйвера = ЛЕВОЕ колесо (рабочее), канал A = ПРАВОЕ (не крутится).
  Пользователь изначально считал наоборот — не доверять маркировке, только тесту.
- **Мотор A (правое колесо) не крутится вообще:** ШИМ 80/150/220/255, обе стороны,
  обе раскладки PWMA/AIN2, а также перебор всех 6 перестановок ролей пинов D4/D5/D11
  и перебор свободных пинов D9/D12/D13/A0..A3 в качестве PWMA — везде ноль.
- **Торможение канала A работает:** правое колесо становится тугим по команде `k a 1`.
  Но это НЕ доказывает исправность PWMA: у TB6612 короткое замыкание обмотки
  возникает и при IN1=IN2=H, и при PWM=L независимо от IN. Тугое колесо ровно
  соответствует «PWM постоянно в LOW». Зато доказывает, что обмотка мотора и
  выходы AO1/AO2 целы.
- **Вывод: обрыв линии PWMA** между Nano и TB6612 (или непропай на модуле,
  или дохлый канал A самого TB6612). Софтом дальше не диагностируется —
  нужен мультиметр.
- STBY (D6) исправен — иначе не работал бы и мотор B, что подтверждает
  правильность трассировки схемы для остальных пинов.
- Разовое зависание при включении аккумулятора: плата перестала отвечать по Serial
  (похоже на залипание I2C от помех мотора), вылечилось сбросом. Нужно добавить
  `Wire.setWireTimeout()` — ЕЩЁ НЕ СДЕЛАНО.

### Баг прошивки, исправлен
Контур скорости обнулял `encA/encB` 40 раз в секунду, поэтому команда `n` почти
всегда показывала нули. Добавлены накопительные `totA/totB`, `n 0` их сбрасывает.

## Настройка регулятора (2026-09-07, вечер)

### Архитектура управления
Каскад, как в литературе по балансирующим роботам:
1. **Внутренний контур, угол** — PID: `kp*(угол-ноль) + ki*интеграл + kd*гироскоп`.
   Интеграл ограничен параметром `imax` (в единицах ШИМ), с защитой от накопления,
   обнуляется при падении и при каждом включении.
2. **Контур скорости** по энкодерам — вклад ограничен `smax`, добавляется к ШИМ.
   Интеграл (`ksi`) выключен: за установившееся смещение отвечает подстройка нуля,
   два интегратора на одну задачу дерутся между собой (проверено, робот уезжал).
3. **Автоподстройка нуля** (`ktrim`) — «tilt set-point correction» из литературы:
   `zero += ktrim * скорость`, только когда робот реально стоит
   (|угол−ноль| < 5° и |гироскоп| < 60 °/с), иначе ноль портится во время падения.

### Найденные ошибки и грабли
- **Знак подстройки нуля был обратным.** Робот ехал вперёд, а ноль уводился ещё
  ниже, то есть коррекция разгоняла его вместо остановки. Правильно: при движении
  вперёд ноль надо ПОВЫШАТЬ. Проверка на данных: при постоянной скорости ускорение
  нулевое, значит текущий угол и есть истинная точка равновесия.
- **Гироскоп упирался в потолок шкалы ±250 °/с** (в логе повторялись r=-259.0 и
  r=241.3). Переведён на ±500 °/с, делитель 65.5 LSB/(°/с). Смещение при этом
  делится пополам — обязательно перекалибровать командой `c`.
- **Калибровка теряется при перепрошивке**, если не сделать `w` сразу после `c`.
  Один раз из-за этого гироскоп полдня врал на 9 °/с.
- **Лог `tools/.serd.log` нельзя дописывать в обход демона** — демон держит
  свой offset, файл получает дыру из NUL-байтов, и `tail` начинает показывать
  СТАРЫЕ строки. Из-за этого был сделан неверный вывод про `so=0`. Лечится
  перезапуском демона (он пересоздаёт файл). Читать лог с `grep -a`.
- **Интеграл контура скорости накрутился до −220 ШИМ** и перевернул управление:
  робот наклонён вперёд, а колёса едут назад. Отсюда ограничитель `smax`.

### Частота ШИМ — измерено
Мёртвая зона (минимальный ШИМ, при котором колесо трогается):

| Частота | Мотор A | Мотор B |
|---|---|---|
| 31 кГц | 28 | 18 |
| 3.9 кГц | 16 | 12 |
| 490 Гц | 14 | 10 |

На высокой частоте индуктивность обмотки не даёт току нарасти за импульс.
Выбрано **3.9 кГц** (делитель Timer1 = 8): вдвое лучше разрешение управления
в области малых поправок. Меняется на лету командой `pwmf 1|8|64`.

### Автонастройка
`tools/autotune.py` — покоординатный спуск по kp, kd, dead. Каждая проба:
выставить коэффициенты, дождаться пока робота поставят на колёса, включить,
записать 6 секунд телеметрии, посчитать цену:

    цена = 3*СКО(угол) + 0.06*СКО(гироскоп) + 1.5*|снос| + 300*доля_времени_лёжа

Человек нужен только чтобы поднимать робота — скрипт сам ждёт этого.

### Диагностика в телеметрии
`hz=` частота цикла (норма 200), `imuerr=` сбоев чтения MPU в секунду (норма 0),
`i=` вклад интегральной составляющей, `so=` вклад контура скорости, `z=` текущий ноль.
Проверено: под полной нагрузкой моторов hz=200, imuerr=0 — цикл не проседает.

## С ЧЕГО НАЧАТЬ ЗАВТРА

Автонастройка отработала полностью, итог сохранён в EEPROM. **НО: пользователь
сказал, что сам робот не стоит.** Цифры ниже — то, что намерил скрипт, и им
нельзя верить без проверки, см. «Дыра в методике».

Результат последнего прогона (`tools/autotune.py`, 4 круга покоординатного спуска):

| Показатель | Начало дня | Итог |
|---|---|---|
| Время стойки | падал за секунды | 15.2 с (потолок теста) |
| СКО угла | 10.5° | 2.6–2.8° |
| Тряска (СКО гироскопа) | 112 °/с | 27–71 °/с |

### Дыра в методике замера — ПОЧИНИТЬ ПЕРВЫМ ДЕЛОМ
`autotune.py` считает пробу успешной, если робот не упал за 15 секунд. Но он
никак не отличает «стоит сам» от «человек держит его в руках». Если руки не
убрали, проба засчитывается как отличная. Поэтому «простоял 15.2 с» вполне может
означать «его держали 15 секунд», а СКО угла 2.6° — просто ровные руки.

Как чинить: признак того, что робота отпустили, надо брать из данных, а не из
доверия. Варианты:
- считать пробу начавшейся только после того, как ШИМ стал заметно работать
  (|pA| > мёртвой зоны) — в руках моторы почти не нагружены;
- смотреть на скорость колёс: у отпущенного робота они постоянно подрабатывают,
  у зажатого в руке стоят;
- проще всего — добавить в прошивку команду «жди отпускания»: включиться и
  начать замер только когда |угол−ноль| качнулось за порог хотя бы раз.

До этого исправления ЛЮБЫЕ цифры автонастройки недостоверны.

Итоговые: `kp=10  ki=3  kd=0.26  dead=12  ksp=2  ksi=0  smax=60  ktrim=0.002
ztrim=6  zero≈0.65  maxpwm=255`, ШИМ 3.9 кГц, гироскоп ±500 °/с.

### Автостарт
Прошивка стартует с включённой балансировкой (`autoen=1`), компьютер не нужен.
Лёжа робот читается как упавший и моторы молчат; как только его поставят на
колёса, срабатывает авто-возврат (`arec=1`) и он начинает держаться сам.
Перед стартом 0.5 с идёт сходимость комплементарного фильтра — иначе первая
поправка считалась бы по недосчитанному углу.
Выключить автостарт: `autoen 0` + `w`.

Подобранные коэффициенты зашиты в `defaults()` в скетче, поэтому переживают
и стирание EEPROM, и смену версии структуры конфига.

### Порядок действий
1. Воткнуть USB, включить аккумулятор
2. `nohup python3 tools/serd.py >/dev/null 2>&1 &` — поднять демон порта
3. `tools/say.sh -t 2 "p"` — проверить, что коэффициенты на месте
4. `tools/say.sh "s 1" "e 1"` — включить и проверить, что стоит

### Что делать дальше, по убыванию пользы
1. **Поднять потолок теста** в `autotune.py` (`--cap 30`) и догнать настройку —
   сейчас все хорошие пробы упираются в 15 секунд, и критерий перестал различать.
2. **Добавить в перебор `alpha`** (постоянная комплементарного фильтра, сейчас 0.98,
   что даёт 0.245 с). При разгоне робота акселерометр ловит собственное ускорение
   и портит угол — вероятно, стоит поднять до 0.995. Это самый вероятный источник
   оставшейся болтанки.
3. **Проверить `dead=9`** — в переборе дал ту же цену, но вдвое меньшую тряску (27
   против 52). Разница в пределах шума, но проверить стоит.
4. **Устойчивость к толчкам** — контур скорости (`ksp`) пока не настраивался,
   его перебор не входил в автонастройку.
5. **Повороты** — `ktp`/`ktd` нулевые, команда `d <скорость> <поворот>` есть,
   но контур поворота не проверялся.
6. **Перенос на HC-05** — поменять `BAUD` в скетче на скорость модуля (обычно 9600
   или 38400), воткнуть модуль на D0/D1. Протокол не меняется, `tools/say.sh`
   продолжит работать через `/dev/cu.HC-05` вместо USB-порта.

### Чего НЕ делать повторно
- Не трассировать `schema.png` — она не соответствует плате, реальная распиновка выше
- Не искать неисправность мотора A — её нет, был неверный пин ШИМ (D9, а не D4/D11)
- Не выяснять, почему акселерометр даёт 0.19g — это смещение нуля по Y, поправки найдены
- Не подозревать нехватку производительности — `hz=200` под полной нагрузкой, `imuerr=0`

## Виртуальный двойник (2026-09-08)

Цель — перестать подбирать коэффициенты руками: в модели проба стоит миллисекунды
и не требует человека, который поднимает робота.

### Что построено, папка `sim/`
- `model.py` — быстрая модель: обратный маятник на колёсах, 4 состояния,
  плюс модель мотора (противо-ЭДС, мёртвая зона, вязкое трение) и режим
  `coast` для выключенного драйвера. Интегратор RK4.
- `sim.py` — **построчная копия прошивочного регулятора**: тот же
  комплементарный фильтр, тот же контур скорости на 40 Гц, та же подстройка
  нуля, те же ограничители. Найденное в модели заливается в робота без правок.
  Плюс модель датчиков, включая то, что акселерометр ловит собственное ускорение
  робота — главный источник вранья об угле в момент резких поправок.
- `mjc.py` — двойник в MuJoCo (стоит в `.venv`, версия 3.12).

### Зачем два движка, а не один
Механика робота — 4 состояния с решением в замкнутом виде, физический движок
закрывает только её. Мотор, энкодер, шум гироскопа, запаздывание фильтра,
насыщение ШИМ, дискретность цикла — всё это пишется руками в любом случае.
Поэтому: быстрая модель для перебора тысяч вариантов, MuJoCo для проскальзывания
колёс, трёхмерности, картинки и **проверки алгебры**.

Сверка сделана: свободное падение с 1/2/5° — расхождение движков **0.2–1.7%**,
оба совпадают с аналитическим полюсом 15.5 рад/с. Алгебре можно верить.

### Найдено при сверке
При нулевом ШИМ TB6612 замыкает обмотку, то есть мотор **тормозит**, а не
катится свободно. Из-за этого «свободное падение» в модели шло в 1.7 раза
медленнее, чем в MuJoCo, где торможения нет. Следствие для замеров:
опыт с отпусканием делать только при выключенном драйвере (`io 6 0`).

### Захват на полной частоте
В прошивку добавлена команда `burst` — 80 отсчётов угла, гироскопа и ШИМ на
частоте цикла (200 Гц, то есть 0.4 с), затем выгрузка в CSV. Телеметрия 20 Гц
для падения за 0.3 с бесполезна. ОЗУ после этого 69%, свободно 630 байт.

### Что нужно измерить, чтобы модель была про ЭТОГО робота
Скрипт `tools/identify.py` снимает с робота:
- `fall` — отпускание с малого наклона, 5 проб, по росту угла считается
  неустойчивый полюс, то есть `m*g*l/(I+m*l^2)`. Самый важный параметр.
- `motor` — ступеньки ШИМ на весу: усиление и постоянная времени привода
- `cpr 1.0` — прокатить ровно метр: импульсы энкодера на метр

От человека нужно то, что робот про себя не знает:
1. **Диаметр колеса**, мм
2. **Масса робота**, кг
3. **Маркировка мотора**: передаточное число и импульсов энкодера на оборот
4. **Высота центра тяжести над осью колёс** (положить набок на ребро карандаша
   и найти точку равновесия)
5. **Высота платы с MPU над осью**

Без пунктов 1 и 3 модель придётся подгонять вслепую сразу по двум параметрам.

## Параметры настоящего робота (2026-09-09, по фото с линейкой)

Мотор по маркировке: **JGA25-370 DC6V 210RPM**, колесо **63 мм**.
Отсюда: передаточное 45:1, энкодер 11 имп/оборот мотора → **495 импульсов на
оборот колеса**, максимальная скорость при 7.4 В — 0.85 м/с.

Размеры сняты по линейке в кадре, масштаб проверен по колесу:

| | над полом | над осью |
|---|---|---|
| ось моторов | 31.5 мм | 0 |
| нижняя палуба | ~54 мм | ~22 мм |
| аккумулятор | ~68 мм | ~37 мм |
| верхняя плата с MPU | ~90 мм | ~58 мм |

Массы — ОЦЕНКА, весов у пользователя нет: моторы 2×100 г, колёса 2×40 г,
аккумулятор 125 г, платы и палубы ~130 г. Итого ~535 г.

### Главный вывод о механике
**Центр тяжести всего 18 мм над осью. Наклон удваивается за 36 мс**
(неустойчивый полюс 19 рад/с). У типового балансирующего робота центр тяжести
100 мм и удвоение 80–100 мс, то есть этот в 2–3 раза «злее». Причина видна на
фото: самое тяжёлое — два мотора JGA25-370 — сидит ровно на оси, колёса 63 мм
тоже, а лёгкий верх поднят недостаточно, чтобы это перевесить.

Это объясняет, почему ручной подбор шёл так тяжело. Робот не сломан и не
раскалиброван — он просто механически трудный.

## Коэффициенты, найденные на модели — ГОТОВЫ К ЗАЛИВКЕ

    kp=10   ki=3   kd=0.06   ksp=12   alpha=0.97   dead=12

Отличие от залитых сейчас: **ksp 2 → 12** (контур скорости в шесть раз сильнее)
и **kd 0.26 → 0.06** (вчетверо слабее). Для короткого маятника это физически
осмысленно: обратная связь по углу одна не справляется, демпфирование должна
давать скорость колёс.

### Проверка на устойчивость к моим же ошибкам в оценках
81 вариант робота (масса ±30%, центр тяжести ±40%, импульсы ±20%, мёртвая зона
0.25–0.5 В), в каждом 3 испытания — наклон вперёд, назад, толчок:

| набор | выстоял |
|---|---|
| найденный моделью | **214 из 243 (88%)** |
| залитый сейчас в робота | **0 из 243** |

То есть вывод не зависит от точности моих оценок массы.

### Что НЕ выяснено
Стоит ли поднимать аккумулятор выше. Перебор при смене геометрии застревает,
потому что стартует из оптимума для нынешней. Вопрос отложен: сначала проверить
найденные коэффициенты на нынешнем железе, переделка может не понадобиться.

## Порядок на следующий сеанс
1. Поднять демон, залить прошивку (в ней уже есть `burst` и автостарт)
2. `tools/say.sh "kp 10" "ki 3" "kd 0.06" "ksp 12" "alpha 0.97" "dead 12" "w"`
3. Проверить, стоит ли — и это будет проверкой не только коэффициентов, но и
   всей модели
4. Если стоит хуже, чем обещала модель — запустить `tools/identify.py fall`:
   он померяет настоящий полюс и покажет, где мои оценки масс врут
5. `tools/identify.py cpr 1.0` — уточнить импульсы на метр (ожидается 495 на
   оборот, то есть 2500 на метр)

## Прогресс

- [x] Распознана схема, вытащена распиновка
- [x] Получены ответы по железу
- [x] Скетч v1: телеметрия + команды + EEPROM + контуры баланса/скорости/поворота
- [x] Прошито, MPU отвечает по I2C, команды работают
- [x] Разобрана проблема акселерометра → смещение нуля, поправки найдены
- [x] Определены оси IMU: axu=3 axf=2 axg=1 axt=3
- [x] Откалиброван гироскоп, конфиг сохранён в EEPROM
- [x] Проверены моторы и энкодеры под аккумулятором
- [x] Найдена реальная распиновка драйвера, оба мотора крутятся в обе стороны
- [x] Определены mvA/mvB, «+» = вперёд
- [x] Измерена мёртвая зона на трёх частотах ШИМ, выбрано 3.9 кГц
- [x] Каскад собран: угол PID + контур скорости + автоподстройка нуля
- [x] Подбор kp/kd/dead автонастройкой: робот стоит, СКО угла 2.6°
- [ ] Догнать настройку с потолком теста 30 с, добавить в перебор alpha
- [ ] Настроить устойчивость к толчкам (ksp) и повороты (ktp/ktd)
- [x] Построен виртуальный двойник, два движка сверены между собой
- [x] Параметры робота сняты с фото, модель заполнена
- [x] Найдены коэффициенты на модели, проверены на устойчивость к ошибкам оценок
- [ ] Залить найденные коэффициенты в робота и проверить
- [ ] Измерить настоящий полюс (`identify.py fall`) и уточнить массы
- [ ] Проверить модель: прогнать записанное реальное падение в симуляторе
- [ ] Перенос на HC-05 (сменить BAUD, воткнуть модуль на D0/D1)
- [x] Скетч gyrobot_mov: адаптивный ноль + энкодерный контур, телеметрия s=/i=
- [ ] Проверить знаки ES_A/ES_B толчком стоя
- [ ] Диагностика тряски: заряд батареи → контрольный запуск (см. 2026-09-21)
- [ ] Залить переразбитый gyrobot_mov (config/imu/motors/speed) после теста батареи

## Гиробот v4 — модель из STL (2026-09-17)

**v4 — это другая машина, а не доработка v3.** Шаговые NEMA17 вместо
редукторных DC, ESP32-S3 вместо Nano, 1293 г вместо 535, колёса 90 мм вместо 63.
Ни один коэффициент из v3 не переносится.

Источники: `gyrobot v4 sim/parametric-model.stl` (ASCII из OpenSCAD, 19528
треугольников) + заметки `~/Documents/obsidian-laba/Гиробот/`:
«промпт для CAD» (параметры и состав) и «отчет кадама» (массы и крепёж).

### Что сделано в sim/
| Файл | Что |
|---|---|
| `v4_mesh.py` | режет CAD-экспорт на корпус и колесо, пишет двоичные STL в `gyrobot v4 sim/mesh/` (MuJoCo ASCII не читает, а шины в OpenSCAD приварены к Deck 0) |
| `robot_params_v4.py` | таблица масс + высоты, снятые с меша → ЦТ, инерция, полюс |
| `mjc_v4.py` | MuJoCo: корпус-меш на свободном шарнире, два колеса, пол |

Система координат CAD: начало — верх Deck 0, ось колёс на +22.15 мм,
пол на −22.85 мм. Отсюда радиус колеса ровно 45 мм.

### Механика v4
    масса 1293 г · ЦТ 40.8 мм над осью · радиус инерции 60.5 мм
    инерция: наклон 4.43e-3 · крен 6.18e-3 · рыскание 2.35e-3 кг·м²
    полюс 10.2 рад/с · удвоение наклона 68 мс
    момент двух моторов 0.80 Н·м → 13.8 м/с² = 1.4 g · шаг колеса 0.088 мм

Сверка движков: MuJoCo при отпускании с 2° сходится с аналитикой на 0.1%.

**Почему ЦТ такой низкий — это не ошибка модели.** 585 г из 1293, то есть
**45% массы, сидит ровно на оси**: два NEMA17 по 280 г плюс энкодеры. Лёгкий
верх на 235 мм не перевешивает. Та же болезнь, что у v3 (там было 18 мм над
осью), просто в мягкой форме — 40.8 мм вместо 18.

**И он действительно ведёт себя «слишком легко».** 0.8 Н·м на радиусе 45 мм
даёт 13.8 м/с² на 1.293 кг — **1.4 g**. Моторы для этой массы избыточны,
поэтому робот отлично отыгрывает возмущения. Хочется натуральнее — либо
поднять груз на Deck 2 (шпильки M4 длиной 170 мм это позволяют), либо
признать, что моторы взяты с запасом.

Детали считаются коробками, а не точками: собственная инерция блока даёт 15%
от общей, без неё робот отвечает регулятору быстрее, чем должен.

### Поправка к отчёту CAD
В отчёте ЦТ = +45.7 мм над осью. Там смешаны две базы: палубы отсчитаны от
Deck 0, а результат назван «над осью». От одной базы выходит **+40.8 мм**.
Разница мелкая, но в полюс входит корнем — лучше считать по мешу.

### Массы — ОЦЕНКА, никто ничего не взвешивал
Взяты из отчёта CAD. Печатные палубы — самое слабое место: Deck 0 по мешу
около 60 см³ PETG, а в отчёте 110 г, то есть почти сплошная заливка.
Мотор-заглушки и коробка аккумулятора в меше есть, их объём в массу палуб
не попадает.

### Чего STL не даёт
Массы и плотности. Геометрию — да, картинку — да, физику баланса — нет.

### Привод: шаговик = источник СКОРОСТИ (решено 2026-09-17)
TMC2209 принимает частоту шагов и держит её ровно, пока нагрузка не превысит
удерживающий момент — тогда срыв шагов. В MuJoCo это `<velocity>` с
`forcerange` ±0.4 Н·м на мотор, `ctrl` = **желаемая скорость колеса, рад/с**.
Никакого ШИМ, мёртвой зоны и противо-ЭДС; контур скорости на энкодерах тоже
не нужен — путь колеса известен по счёту шагов.

`model.py` и `sim.py` от v3 к v4 неприменимы: они про DC-мотор. Переписывать
их не надо, вся v4 живёт в MuJoCo.

### Регулятор `ctl_v4.py`
LQR по 4 состояниям `[наклон, скорость наклона, путь, скорость]`, выход —
скорость колёс в м/с. Плюс отдельный контур курса.

    K = наклон 17.4 · скорость наклона 2.90 · путь 1.22 · скорость 3.85
    TAU 60 мс · разгон до 8 м/с² · потолок 1.5 м/с
    K_HEAD 12 (курс) · K_YAW 2 (угловая скорость)

Ключевой момент: **идеальный источник скорости стабилизировать нельзя** —
наклон чувствует только производную команды. Запаздывание должно быть где-то,
и место ему в регуляторе: сервопривод MuJoCo выходит на новую скорость за 1 мс,
ни один шаговик так не умеет. Поэтому `ctl_v4.step` разгоняет собственную
команду с той самой TAU, под которую считался LQR, и упирается в потолок
разгона, который два 17HS4401 реально дают.

Проверка — `sim/test_v4.py`:

    СТОЙКА  толчок 5 Н | макс наклон 11.4° | СКО 3.8° | уполз 28 см
            рыскание СКО 0.93°, макс 2.7°, вбок 12 мм
            держит толчок до 6 Н за 0.12 с на высоте 160 мм
    ЕЗДА    0.5 м/с 4 с | средняя 0.52 | проехал 2.24 м | макс наклон 6.0°
    ПОВОРОТ 1.5 рад/с 4 с | повернулся ровно на 344° | снесло на 9 см

В тишине СКО наклона 0.9°.

Перебор TAU × вес наклона × R (24 варианта): разброс СКО всего 0.73–1.30°.
Настройка пологая, точные веса не важны.

### Пять ошибок, найденных катанием (2026-09-17)
Каждую нашёл человек за рулём, ни одну — расчёт. Симулятор без окна врал бы
молча.

1. **Опорная точка пути ехала от времени.** Было
   `travel - want_speed * d.time`: нажал «вперёд» на 30-й секунде — цель
   прыгнула на 24 метра назад, робот бросился за ней и упал.
   Стало `ref += cmd_speed * dt`, и двигает её **только команда водителя**.
   Двигать её собственным выходом регулятора тоже нельзя: тогда абсолютной
   привязки не остаётся и робот уезжает шагом пешехода.
2. **Рампа была ограничением скорости нарастания, а не запаздыванием.**
   LQR считался под апериодическое звено с TAU, а получал ступеньку с
   ограничением 8 м/с² — разные объекты, отсюда качели.
3. **Угловая скорость бралась из `d.qvel[5]`** — это локальная система
   наклонённого корпуса. Нужен пересчёт в мировую: `mjc_v4.yaw_rate`.
4. **Толчок прикладывался в центр масс, то есть на ось.** `xfrc_applied`
   действует в центре масс тела — плечо ноль, опрокидывающего момента нет,
   робота просто сдвигало. `mjc_v4.shove` бьёт на высоте 160 мм и досчитывает
   момент от плеча: тот же толчок 6 Н даёт наклон 15° вместо 7°, потолок упал
   с 11 Н до 6.
5. **Путь и скорость читались с ОДНОГО колеса.** При повороте половина
   разницы колёс уходила в контур баланса как «проехал вперёд», курс уплывал
   и робот ехал боком. Стало: среднее двух колёс — это путь, разность — это
   поворот. Плюс контур курса `K_HEAD`, иначе после толчка робот навсегда
   остаётся в новом направлении.

Плюс два ложных диагноза: поворот работал с самого начала (меряли `atan2`, а
он заворачивается после 180°), и жёсткость сервопривода `kv` подняли с 4 до
40 — шаговик не проседает по скорости под нагрузкой, он держит частоту шагов
точно до самого срыва.

### Смотреть и рулить
    .venv/bin/mjpython sim/v4_view.py
mjpython, не python: на macOS окно MuJoCo должно владеть главным потоком.
По умолчанию — ручной режим, робот стоит и ждёт команд.

    8 / 2  быстрее вперёд / назад      4 / 6  поворот влево / вправо
    5      стоп                        E / O  толчок вперёд / назад
    Y      поставить заново            P      сценарий сам по кругу

**Почему именно эти клавиши.** Интерфейс вьюера съедает стрелки, пробел,
Backspace и почти все буквы: они назначены на переключатели отрисовки
(W каркас, T прозрачность, C контакты, S тени, R отражения, I инерция,
M центр масс, B сила возмущения и так далее — список в `mjVISSTRING` и
`mjRNDSTRING`). Свободны цифры и буквы E, O, P, Y. Любая клавиша, которая
всё-таки дошла до скрипта, печатается в терминал — если что-то не работает,
сразу видно, дошла она или её съели.

Запасные ходы: набирать те же буквы в терминале и жать Enter (работает,
только если скрипт запущен из терминала), и толкать мышью — двойной клик по
корпусу, затем Ctrl + правая кнопка, это штатное возмущение вьюера.

### Две ловушки вьюера, найденные при первом же катании
1. **`mj_resetData` отматывает часы на ноль.** Толчок, назначенный до
   `t = 40.15`, после падения и подъёма получает ещё сорок секунд жизни —
   робота непрерывно толкает, он набирает скорость и падает снова, и так по
   кругу. Всё, что привязано ко времени, надо гасить вместе с часами.
2. **Обработчик клавиш живёт на потоке вьюера,** а `mj_step` — на главном.
   Трогать `mjData` прямо из обработчика — segfault (получили, код 139).
   Клавиша только ставит флаг, а делает всё главный цикл.

### Что ещё не проверено
- Реальные массы (весов нет)
- Кривая момент-скорость 17HS4401 при 3S (12.6 В) через TMC2209
- Робот v4 физически не собран

## Сессия 2026-09-21: gyrobot_mov (энкодеры), тряска после шкафа, рефакторинг

Актуальная платформа: Nano + MPU-6050 + TB6612 + 2S. v4/v5 (ESP32+шаговики) —
только в симуляции, физически не собраны. Рабочий скетч — `firmware/gyrobot_mov/`
(порт listing_PID_2I_mov). Порт: **COM10** (дефолт COM9 во flash.ps1 устарел,
проверять `arduino-cli board list`; сегодня плата не опозналась, но COM10 — USB-serial).

### Энкодерный контур — добавлен, проверен на столе
- speed.ino: окно 40 мс, тяжёлый EMA (SFILT=0.9), путь ±2000 имп (±80 см),
  `speedTerm = KSP*speedFilt + KSI*speedInt` добавлен к выходу PID; сброс при взводе.
- Телеметрия: idle `s=`, armed `s=`/`i=`. Ручная прокрутка колеса: s ходил
  +3.8…−3.6, фильтр гладкий — проводка и чтение живые.
- **Знаки ES_A=1/ES_B=-1 — допущение, не проверено стоя.** Если при толчке вперёд
  робот уезжает вперёд сильнее — флипнуть в config.h.

### Проблема: робот ОЧЕНЬ трясётся стоя (появилась ДО сегодняшней прошивки)
Несколько дней лежал в шкафу; до этого балансировал нормально (качка ±1.5° @ 3.5 Гц).
Факты: лёжа моторы молчат (драйвер/проводка ОК), трясётся только стоя; колёса от
руки свободные; батарея давно не заряжалась.

Лог под нагрузкой (11 с балансировки, tools/talk.py):
- x= бьётся +255/−255 без пауз — bang-bang, постоянная сатурация ШИМ
- r= до 380–450 °/s при угле ±3–5° (было ~33 °/s) — раскачка выросла в 10+ раз
- hz=884 стабильно под нагрузкой (idle 1160) — I2C жив, таймаутов нет, управление ОК
- s= реально ±25 имп (0.25 м/с) — робот физически мечется туда-сюда
- zr= за 11 с гулял 1.4→4.3→2.7 — адаптивный ноль гоняется за качелями (следствие)
- bias гироскопа при взводе 1107 LSB = 16.9 °/s (2026-09-07 было 8.8 °/s) —
  автокалибровка компенсирует, но дрейф растёт, следить

### Гипотеза и план (systematic-debugging, фаза 3, В ПРОЦЕССЕ)
- Гипотеза: саморазряд батареи → моторам не хватает момента → настроенный контур
  уходит в предельный цикл с сатурацией. Все симптомы сходятся.
- Минимальный тест: **зарядить батарею, повторить запуск, сравнить лог.**
  Код и механику до теста не трогать — одна переменная за раз.
- Если не подтвердится: тугие колёса под нагрузкой, покрытие/скользкость пола,
  люфт/подвес MPU (двусторонний скотч мог отойти).

### Рефакторинг — готов, НЕ залит
- gyrobot_mov разбит в стиле v5: config.h (пины/константы/extern/прототипы),
  imu.ino, motors.ino, speed.ino, main (состояние + setup/loop).
- Компиляция байт-в-байт та же (11336 flash / 509 RAM). Залить ПОСЛЕ теста батареи.

### Инструменты
- talk.py теперь пишет --out на лету (flush после строки): убитый процесс лог
  больше не теряет. Раньше писал файл только в конце — один лог так потеряли.
- Захват: `python tools/talk.py --port COM10 --boot 2.5 --listen 600 --out <файл>`;
  открытие порта ресетит плату (бут + калибровка 2 с + автовзвод при стойке 1 с).

### Чего НЕ делать
- Не винить энкодерный контур в тряске — она была до его заливки
- Не поднимать KSP/KSI «на глаз» до проверки батареи — усугубит предельный цикл
- Не верить дефолтному COM9 во flash.ps1

### Итог дня: три находки и перезапись с нуля
1. **Батарея невиновна** (зарядил — трясётся). Колёса от руки свободные.
2. **БАГ: шкала гироскопа.** Регистр 0x1B не писался никогда: чип жил на дефолтных
   ±250 (131 LSB), а GYR_LSB=65.5 -> rate x2, D-член x2. Улика: bias при взводе
   1107 LSB = 8.8 °/с только если чип на ±250 (исторический gbx=1157 на ±250;
   на ±500 было бы ~554). Теперь 0x1B=0x08 пишется в mpuWake().
3. **Яд адаптивного нуля.** При тряске (18 Гц дребезг, burst: +-15 °/с при
   амплитуде угла +-0.1°) ноль при гейтинге |pid|>0.7 уполз до клампа -15.000
   и застрял: каждый взвод сеял угол с ошибкой до -8° -> робот не мог стоять
   в принципе. В оригинале после падения программа останавливалась наглухо,
   ноль не выживал. Наш автовзвод тащил отравленное состояние.
4. Гипотеза «энкодерный контур» снята: с KSP=KSI=0 тряска та же.
5. **gyrobot_mov переписан с нуля** по образцу listing_PID_2I_mov: минимум кода,
   порядок цикла оригинала, гейт ноля как в оригинале (только |pid|>0.7,
   кламп-страховка ±15). Выброшены: энкодеры (сохранены в
   backup/speed_encoders.ino.txt), burst, гейтинг ноля по rate/углу.
   Оставлены железные необходимое: TB6612+3.9 кГц+PWM_MIN=16, оси/офсеты MPU,
   mpuWake() с 0x1B, bias-калибровка на старте, I2C-таймаут 25 мс, автовзвод.
   KP=0.55 KD=0.02 KI_S=5.0 TAU_ACC=2.0 ZR_RATE=4.0 FF_RATE=8.0 PID_DEAD=0.4.
   9730 байт flash / 475 RAM. Телеметрия: a= r= pid= zr= x= hz=, idle + armed a/bias/zr.
6. Не решено: почему «работало 18.09» — бекапа нет, воспроизвести тот билд нельзя.
   Возможно, тряска была и тогда в мягкой форме (в коде: «качка ±1.5° @ 3.5 Гц»).
   Если после чистой перезаписи трясёт: очередь проверок — DLPF (0x1A=0x03, 44 Гц,
   как в v5), покрытие/протёртые колёса, крепление MPU.

### Тюнинг после перезаписи (вечер 2026-09-21) — рабочий набор
- kd: 0.02 «норм» -> 0.01 лучше -> 0.007/0.005/0.003 -> оставили **0.007**; kp=0.5
- Ноль стартовый **0.4** (было 1.4). Адаптивный ноль: гейт |pid|>0.7 + защита
  |угол|<10 и |rate|<60 — без неё падение само отравляло ноль (робот вставал
  с наклоном и пятился) — ГЛАВНЫЙ ФИКС вечера
- Энкодерный контур вернули: **ksp=0.3** (0.05/0.1 слабо, 1.0 самокачание),
  **ksi=0.005** против медленного уезжания (0.002 мало). Знаки esA=1/esB=-1
  подтверждены толчком. Память позиции УТЕКАЕТ (×0.995 за окно ~5 с) — иначе
  робот пятится к старту вместо удержания нынешней позиции
- Контур курса по РАЗНОСТИ колёс: kdy=0.1 (демпфер вращения) + kdi=0.004
  (удержание), дифференциал ±30 в drive(), только при вращении моторов.
  Статические atr/atrb обнулены — курсом владеет только контур
- Живые параметры по сериалу: kp kd ki dead imax pmin ksp ksi esa esb atr atrb
  kdy kdi, «p» — показать. talk.py: команды с пробелом шлём как «kp=0.6»
- Не донастроено (на потом): pmin (16; моторы A/B сами себя раскачивают —
  пробовать 12/10, следить за рысканием: мёртвые зоны A=16/B=12 разные),
  dребезг стояния, точные atr/atrb если контур курса не справится
- COM10 болячка: после нескольких переподключений порт «висит» (error 5),
  лечится передёргиванием USB-кабеля

## WASD-управление по Bluetooth (вечер 2026-09-21) — РАБОТАЕТ

Спека: `docs/superpowers/specs/2026-09-21-wasd-bt-drive-design.md`,
план: `docs/superpowers/plans/2026-09-21-wasd-bt-drive.md` (частично устарели:
финальная реализация — порт c_movement, не «наклонный» подход A).

### Железо и связь
- HC-05 на штатном месте D0/D1 (TX→D0, RX→D1 через делитель 1к/2к).
- Бод модуля переведён на **115200** (разово, скетч-прокладка
  `tools/hc05_at_bridge` — стучит AT+UART=115200,0,0 по кругу на трёх бодах,
  т.к. AT-бод у клонов разный). Перепрошивка: **модуль вынимать из разъёма**,
  иначе TX глушит загрузчик (not in sync).
- Windows: исходящий порт **COM13** (входящий COM12, COM6/7 — посторонний
  BrainLink). Клиент: `tools/wasd.bat` (двойной клик) → `tools/wasd.py`
  (pynput + pyserial, WASD по виртуальным кодам — раскладка не важна,
  шлёт буквы 10 Гц, ESC — выход).
- USB и BT живут вместе, пока по BT только слушают; при заливке модуль вынимать.

### Управление (порт c_movement из listing_PID_2I_mov)
- Буквы w/s/a/d → flagMove (1/2/3/4) с таймером (mper=200 мс, клиент продлевает).
  Букв нет 200 мс → стоим.
- w/s: прямые рывки moveRaw(±mfwd,±mfwd), mfwd=200; a/d: moveRaw(∓mtrn,±mtrn),
  mtrn=110, ТОЛЬКО при |pid|<0.7 (ровно стоит); перекос |pid|>0.7 — баланс
  перекрывает движение (их приоритет). Падение сбрасывает flagMove.
- Живые параметры: mfwd, mtrn, mper + весь старый набор (kp kd ki dead imax
  pmin ksp ksi esa esb kdy kdi kdif zr), «p» — показать.

### Болячки и уроки вечера
- Гуляние адаптивного ноля = причина сноса стоя («сознательное движение» так
  работает): гейт приоткрывается микрокачкой, ноль ползёт, робот едет.
  Гиро-контур поворота, якорь позиции, гигиена ноля — попробованы и откатаны
  (не прижились). Итог: zr=1.6 в дефолте, ползание приемлемое. ksi=0.005 и
  курс-контур kdy/kdi активны со времён стабильного коммита.
- Для точной езды в будущем: каскад по энкодерам (подход C,
  speedOut = ksp*скорость + ksi*путь) — из gyrobot/gyrobot.ino, там же
  ktd×yawRate по гироскопу Z для поворотов. Не реализовано.
- Шкала гироскопа: 0x1B=0x08 обязана писаться при старте (mpuWake) — без неё
  rate x2 и тряска. Признак бода/шкалы: bias при взводе ~550 (±500) vs ~1100 (±250).

## Сессия 2026-09-28: переход на схему Tumbller — СТОИТ, ЕЗДИТ, ПОВОРАЧИВАЕТ

Исследование (`docs/research/Балансирующий робот Arduino эталон.md`, заметки в
`docs/research/notes/`): все проверенные наборы (Elegoo Tumbller, Keyestudio, Yahboom,
Osoyoo, 平衡小车之家) — один трёхконтурный шаблон. Наши «адаптивный ноль» и
«езда сырым ШИМ с фазовым гейтом» были изобретениями против него.
Рабочий скетч теперь **`firmware/gyrobot_tumbller/`** (старые удалены 2026-09-29,
есть в истории git). Порт USB COM10, BT COM13, клиент — `wasd.bat` в корне.

### Схема
`u = KP·θ + KD·ω + KSP·v + KSI·(положение − цель) ± поворот`, угол каждые 5 мс,
скорость 40 мс. Ноль угла фиксирован (az), центр тяжести выбирает интеграл
положения (сброс при взводе/падении). W/S — цель внутри интеграла с рампой.

### Подобрано (вшито в дефолты)
kp 20 · kd 0.5 (0.3 тряска 5 Гц, 0.7 раскачка) · ksp 8 · ksi 0.25 · az −2.8 ·
dba/dbb 6/4 (12/9 дёргало) · acc 0.7 · dec 0.45 · bleed 20 (40 — тряска на остановке) · kt 0.5 (1.0 — «танец») ·
tff 0.3 · kh 1.0 · pvt 1 · kw 4 (8 рывки) · kwi 0.5 · fla 10 · pks 3 (4 качка).
Все живые по сериалу/BT, `p` — показать.

### Грабли и уроки
- **Калибровка гироскопа**: сбитый ноль (25 °/с) = робот стоит с наклоном и
  крутится на месте (удержание курса держит ложный курс). Гироскопу нужно ~15 с
  прогрева. Теперь: окна по 2 с, два подряд должны совпасть; пока не откалиброван —
  не взводится; первая калибровка = **колёса дёргаются вперёд** (сигнал «готов»).
  Порядок: включить, положить на бок, ждать рывка, ставить.
- **Остановка W/S**: робот отставал от цели на 16 см и проскакивал. Лечится
  медленной симметричной рампой + `bleed` (после отпускания интеграл возвращается
  к значению до езды).
- **Повороты — долгая история.** Отстаёт колесо, крутящееся назад; левое на
  полу туже (HC-05 слева, в воздухе моторы равны: замер `step`). Итог:
  при повороте на месте (pvt 1) — PI скорости колёс по **периоду импульсов**
  (200 Гц, счёт импульсов за 5 мс даёт 0–3, бесполезен), **только разность**
  колёс (общая часть = «неверный» для балансира знак, разгон через ~1 с),
  прямая подача трения левого (fla), и **KSP×3 в повороте** — это демпфер качания
  центра (при развороте шины вязнут → восьмёрка вместо круга).
  Не прижились (удалены из кода): заморозка контура скорости (падал), адаптивный
  tba (ушёл в потолок → «танец»), PI колёс с общей частью (разгон).
- **Внутренний регулятор скорости под балансом (как EduBal) — не делать**:
  τ мотора 35–50 мс ≈ полюс робота 19 рад/с, запаса нет (замер `step`).
- Сумму колёс (езда) напрямую по энкодерам не регулировать: это рычаг баланса.

### Диагностика в прошивке
`t 60` — моторы вперёд 1 с (totA/totB обязаны расти в +) · `step 80` — ступенька,
CSV скорости по 5 мс · `z` — ноль = текущий угол · `s` — поток телеметрии.
`wasd.py` пишет телеметрию в `tools/logs/` с отметкой клавиш.

## 2026-09-30: попытка убрать дрожь стоя — программно дальше не уменьшить

Замеры по 40 с стойки (`tools/standstat.py`), разброс между одинаковыми
замерами ~20%. База kp 20: угол ±0.64–0.78°, гироскоп ±14–16 °/с.
- гладкая скорость по периоду в контуре скорости, зона нечувствительности
  выхода 3 ШИМ, сглаживание гироскопа в D-члене, DLPF 94 Гц — **без эффекта**
  (сглаживание D даже чуть хуже: запаса по задержке нет);
- kp 14: гироскоп ±9.5 (быстрая дрожь меньше на треть), но после толчка
  раскачка дольше, а в повороте раскачивается и **падает**; kp 11 — ещё хуже.
Вывод: остаточная дрожь — баланс поверх люфта колёс. Оставлен kp 20;
дальше только механика (люфт колёс/редуктора, выше центр тяжести).
Экспериментальные параметры из прошивки убраны.

## 2026-09-30: дрожь при торможении после W/S — ничего не прижилось

Заезды по 4–5 остановок, разбор `tools/stopstat.py` (дрожь гироскопа 2 с после
отпускания). База: после W 18–23 °/с, после S 40–47. Проверено и откачено:
- цель скорости в П-части контура скорости (kpm, как Balanduino) — проезд дальше;
- медленнее фильтр угла (kacc 0.01) — торможение чуть спокойнее, проезд длиннее;
- вычитание ускорения по энкодерам из акселя (kac ±1) — оба знака хуже;
- bleed «списать долг один раз» (интеграл не прибивается) — дрожь после S 33,
  но робот проезжает и возвращается назад;
- потолок отставания при езде (lagm 150) — назад почти не едет (там нужен больший наклон).
Причина, вероятно, та же, что стоя: смена знака момента при торможении
перещёлкивает люфт редукторов. Оставлено как было (bleed 20, dec 0.45).
Из прошивки убраны неиспользуемые step, vAF/vBF, переключатель pvt: ОЗУ 71% → 39%.

## 2026-09-30: одометрия, карта и возврат домой (H / R)

Спека и план: `docs/superpowers/specs|plans/2026-09-30-odometry-home*`.
- Путь по энкодерам, курс по гироскопу Z (колёса на развороте проскальзывают).
- **Энкодер: ~285 имп/оборот колеса, а не 495** (рулетка: 85 см реально при 49
  насчитанных по 0.400 мм/имп) → `MM_PER_CNT 0.694`. Паспортное 45:1 не
  подтверждается. Контроль: 78 см реально → 82 по карте (5%).
- Возврат: TURN → DRIVE (замедление `knd`, стоп с учётом тормозного пути) →
  FACE (доворот в исходный курс до `ftol` 2°). Промах 2–5 см после одной поездки.
- Найдено на железе и исправлено:
  - поворот на месте на скорости: усиленный демпфер `pks`×KSP×v давал ШИМ 255
    и наклон ±28° (доворот дома на скорости 17) → множитель `pks` плавно гаснет
    к 1 при |v|→6, доворот стартует только когда робот почти встал;
  - жёсткий порог скорости дёргал поворот (режим вкл/выкл) → убран;
  - после отпускания W цель скорости гаснет ~1.3 с, и A/D шли старым поворотом
    одним колесом → поворот на месте определяется по отпущенной W/S.
- Двойное интегрирование акселерометра для положения не делаем: смещение 0.01 g
  = 5 м за 10 с, а у балансира 1° ошибки угла = 0.17 м/с² ложного ускорения.
  Для точности дальше — абсолютные ориентиры (AprilTag с камерой).

## 2026-10-06…08: камера OpenMV H7 Plus на роботе

- Питание камеры — понижайка 5.07 В от аккумулятора (VIN камеры держит только
  3.6–5 В). Роботу не мешает: 200 Гц, сбоев MPU нет.
- Провод P4 (UART3 TX) → D12: прошивка читает программным UART 9600 и пишет
  в телеметрию `cam> ...` (тест `tools/openmv/uart_test.py`, без потерь).
- Видео по Wi-Fi (шилд WINC1500, только 2.4 ГГц): стример
  `tools/openmv/main_stream.py` стоит на камере как `main.py`; клиент WASD
  показывает его в окне (`tools/wasdcam.py`), сам находит камеру в сети.
- Грабли стримера: OpenMV IDE с ним не уживается (рвёт USB); один молчащий
  клиент вешал сервер (нужен таймаут); браузер после зависаний держит мёртвые
  соединения (помогает инкогнито); `hand_detect` падал на новой прошивке, когда
  в кадре появлялся цвет кожи (`b.pixels()` — уже не метод) — убран совсем.
  Любой сбой теперь = перезагрузка камеры, причина в `last_error.txt`.
- **Ноль с камерой: az −10.5** (без камеры −2.8): центр тяжести ушёл назад,
  робот стоял с перекосом −7.5° и «долгом» 600 импульсов. Равновесный угол
  гуляет ±1° между включениями — компенсирует интеграл.
- Подбор с камерой (замеры 40 с): ksp 8 / ksi 0.25 — оптимум (в обе стороны
  хуже); kp 26 и dba/dbb 14/11 по цифрам спокойнее (угол 0.41° против 0.64°),
  но в езде хуже — дрожь на остановке, повороты не обоими колёсами.
  **Оставлены kp 20, dba/dbb 6/4** — решает ощущение от езды, не замер стойки.

## 2026-10-08…09: робот едет за красным мячом

- Камера (`tools/openmv/main_ball.py`, стоит как `main.py`; `main_stream.py` удалён):
  `find_blobs` по порогу LAB (10,70, 25,80, −5,50 — у мяча A 34…45, у стола, стен
  и тени до 21), самое крупное пятно; 10 раз/с по UART 19200 шлёт `b<x>,<размер>`
  или `n`. 47 кадр/с без зрителя, 35 с видео. Страницы `/color`, `/thr?v=...`,
  `/status` (с причиной прошлого сбоя).
- Прошивка: режим `g` (NAV_BALL). Камера задаёт только цель курса
  (`ballHd = heading − 0.18°·x`), доворачивает гироскоп на 200 Гц — тем же
  поворотом на месте, что и возврат домой. Дистанция — по размеру мяча (`bw`),
  скорость ≤ `bmax`, пороги с гистерезисом. Мяча нет 0.5 с — стоит.
- Замеры: 5.5–5.8 пикс/° (0.18 °/пикс); мяч в 68 см — 23 пикс; при `bw 45`
  встал в 40 см. Поставлено `bw 60` (≈ 25–27 см).
- Грабли прошивки камеры (новая, с модулем `csi`):
  - поля пятна по номерам — только рамка [0..3]; [5], [6] — НЕ центр. Из-за
    этого робот «отворачивался от мяча», а знак поворота был верным с начала;
  - `draw_rectangle` / `draw_cross` принимают координаты только кортежем —
    иначе TypeError и перезагрузка, как только мяч в кадре при зрителе;
  - статистика по номерам тоже не та — брать по именам (`l_min`, `a_mean`…);
  - WINC отдаёт новому клиенту номер сокета ушедшего зрителя, а send в закрытое
    соединение ошибки не даёт — видео уходило чужому клиенту (сверяем `fd=`);
  - пока есть зритель видео, второго клиента модуль не принимает вовсе.
- UART 19200 на SoftwareSerial: раз в 1–2 с перед сообщением приходит мусорный
  байт — непечатные символы сбрасывают строку, потерь после этого нет.
- Повороты на месте после всех правок — как были: колёса 7–9 имп/40мс каждое,
  качание v СКО 1.4–2.7 (замер 3×A, 3×D).
