w1zard999/Gyrobot/docs/sessions/2026-09-21.md

# Контекст сессии 2026-09-21 — WASD по Bluetooth (для продолжения в новой сессии)

Читать вместе с STATUS.md (там вся история железа и прошивок). Этот файл —
рукопожатие для новой сессии: что сделано, что НЕ проверено, что делать дальше.

## Текущее состояние (залито в плату, коммит 5459191+)

Прошивка: `firmware/gyrobot_mov` — стабильная база (0f76ab2) + WASD-порт
c_movement из оригинального листинга (listing_PID_2I_mov).

- **Стояние**: работает. zr=1.6 (зашит, подобран бисекцией по полу), гуляющий
  ноль оставлен как есть (пользователь принял лёгкий дрейф).
- **Повороты A/D**: работают (mtrn=40, плавный фейд по |pid|/0.7).
- **Езда W/S: НЕ ПРОВЕРЕНА.** Только что залит «фазовый гейт»: рывок
  moveRaw(±mfwd) даётся только в фазе качки `rate >= 0` (вперёд) /
  `rate < 0` (назад), в чужой фазе моторы держат ход. **Знак фазы не
  проверен** — если W/S дрожат как раньше, первой правкой развернуть:
  `bool phaseFwd = (rate < 0);` в gyrobot_mov.ino (шаг 1).
- mfwd=50, mtrn=40 (живые параметры; 200 было — трясло, 50 — не проверено
  с фазовым гейтом).

## Управление

- Клиент: `tools/wasd.bat` (двойной клик) → `tools/wasd.py`, WASD по
  виртуальным кодам (раскладка не важна), шлёт буквы 10 Гц, ESC — стоп.
- BT: HC-05 на D0/D1, 115200, исходящий порт Windows **COM13** (COM12 —
  входящий, COM6/7 — чужой BrainLink).
- USB и BT сосуществуют (слушать по USB можно во время езды по BT).
- **Прошивка: сначала вынуть HC-05 из разъёма** (его TX на D0 глушит
  загрузчик), залить, вставить. COM10 иногда «висит» — передёрнуть USB.

## Живые параметры (по сериалу, «p» — показать)

kp kd ki dead imax pmin ksp ksi esa esb kdy kdi zr mfwd mtrn mper.
Текущие важные: kp=0.5 kd=0.007 imax=1.0 pid_dead=0.4 ksp=0.3 ksi=0.005
kdy=0.1 kdi=0.004 pmin=16 mfwd=50 mtrn=40 mper=200 zr=1.6.

## Попытки езды, которые НЕ прижились (не повторять без нужды)

1. Подход A «наклоном равновесия» (drv двигал равновесие): робот дрожал —
   движение и баланс бьются за моторы. Откат.
2. Гиро-контур поворота (90°/с по GyZ, ktrns) и нормализация колёс kdif:
   работали, но в сумме робот вёл себя странно — откатаны вместе со всеми
   WASD-правками. Идея хорошая — вернуться, когда базовая езда поедет.
3. Компенсация мёртвых зон atr/brt в moveRaw — сейчас их там НЕТ (moveRaw
   пишет сырые ШИМ). Если левый мотор ленится на mfwd=50 — добавить
   прибавки в moveRaw (atr=16/brt=12 как в стабильном drive).

## Почему дрожала езда (разобрано)

Двигаться балансирующему роботу мешает его же баланс: W даёт +50 на оба
колеса, корпус заваливается назад, баланс (порог 0.7) бьёт колёсами назад,
потом вперёд — рубильник ±50 = дрожь. Оригинал лечил фазовым гейтом по
гироскопу (рывок только в фазе наклона вперёд) — этот механизм сейчас в
прошивке и ждёт проверки. Второй рычаг — величина mfwd (200 было много,
у оригинала моторы слабые и мёртвая зона 100).

## Порядок продолжения

1. Вставить HC-05, включить робота, `wasd.bat`, поставить на пол.
2. W: едет плавно? Да — подобрать mfwd (70/90/120) и go. Нет — флип
   `phaseFwd` (строка с `rate >= 0`), перезалить, снова тест.
3. S: аналогично назад. A/D: повороты не сломались?
4. Подобрать mfwd/mtrn по вкусу, ЗАШИТЬ дефолты, коммит, обновить STATUS.md.
5. Идея на будущее: каскад по энкодерам (подход C) —
   `speedOut = ksp*скорость + ksi*путь` из `gyrobot/gyrobot.ino` (там же
   ktd×yawRate для поворотов) — точная езда вместо рывковых фаз.
