w1zard999/Gyrobot/schema.png

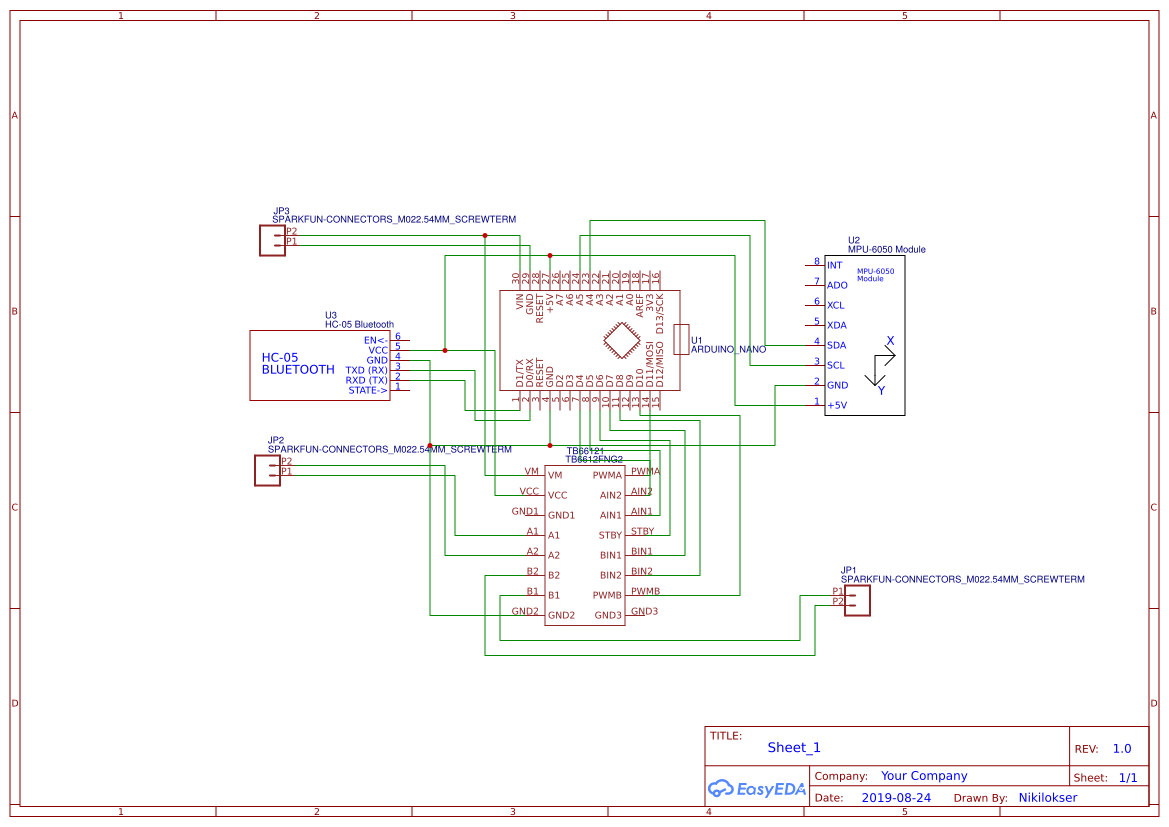
schema.png
