w1zard999/Gyrobot/docs/camera-wiring.png

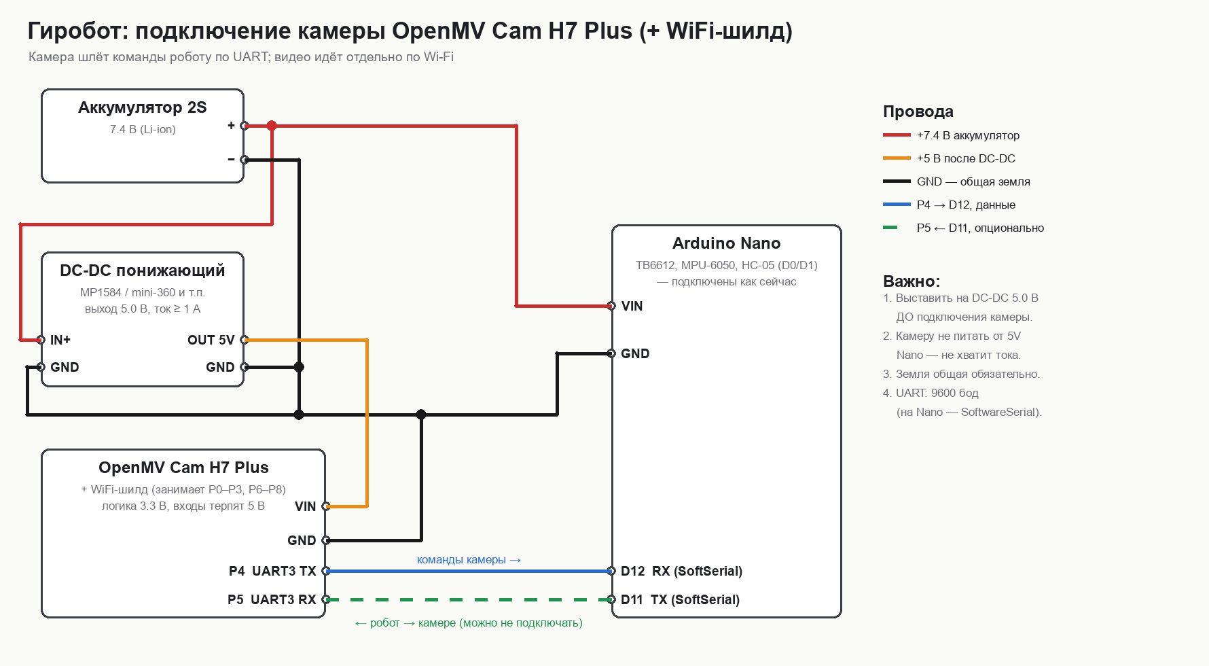
docs/camera-wiring.png
