w1zard999/Gyrobot/(commit log)

2026-09-17 Начало: статус проекта, схема, спека прошивки v5
2026-09-17 plan: прошивка v5
2026-09-17 v5: прошивка — каскад угла/скорости/позиции, протокол, EEPROM
2026-09-17 v5: калибровка гироскопа, тест знаков моторов/энкодеров (esA=-1,esB=+1,mvA=+1,mvB=+1), tools talk.py (gap/utf8) + flash.ps1
2026-09-17 v5: возврат знаков v4 (esA=+1,esB=-1,mvA=-1,mvB=-1) — тест колёс был истолкован неверно
2026-09-21 mov: перезапись по listing_PID_2I_mov — фикс шкалы MPU и отравления ноля падением, энкодерный + курсовой контуры, живые параметры по сериалу; talk.py: лог на лету, команды через =
2026-09-21 спека: управление WASD по BT (HC-05 на D0/D1 + ПК-клиент) — наклон равновесия и дифференциальный поворот
2026-09-21 план: WASD/BT — 5 задач (прошивка x2, HC-05, wasd.py, полевой тест)
2026-09-25 mov: WASD-состояние, буквы в парсере, watchdog 300мс
2026-09-25 mov: WASD едет — наклон в фильтр, дифференциал в drive, угасание yawInt
2026-09-25 tools: wasd.py (руление с клавиатуры) + hc05_at_bridge (перевод HC-05 на 115200)
2026-09-25 mov: по-колёсный знаковый привод (поворот на месте), drv знак/сила по полевому тесту
2026-09-25 tools: wasd.bat — запуск клиента двойным кликом (COM13 внутри)
2026-09-25 tools: wasd.py — защита от key.char=None (краш листенера)
2026-09-25 tools: wasd.bat — ASCII + CRLF (cmd ругался на LF и кириллицу)
2026-09-25 tools: wasd.py — WASD по виртуальным кодам, работает на любой раскладке
2026-09-25 mov: trn 60 (оба колеса в противоход), drv 7 (скорость), zr не ползёт при рулении
2026-09-25 mov: гигиена адаптивного ноля — заморозка при рулении, кламп ±3, утечка ~1 мин
2026-09-25 mov: откат ноля к простому виду (гейт угол/rate, кламп ±6) — гигиена не прижилась
2026-09-25 mov: drv 9 (быстрее ход), trn 45 + мягкая рампа поворота
2026-09-25 mov: компенсация мёртвых зон по моторам (atr/brt, только при вращении) — обе колесят в повороте, ровный ход
2026-09-25 mov: drv 15 (скорость), trn 60 (сила поворота), brt 15 (ровный ход)
2026-09-25 mov: якорь позиции при езде (ksi не тормозит), нормализация колёс по энкодерам (kdif)
2026-09-25 mov: гиро-контур поворота (90 гр/с), drv 17, pmin 24, чистое отпускание WASD
2026-09-25 mov: инверсия знака гиро-контура поворота (ktrns=-1)
2026-09-25 mov: откат на стабильную + WASD как c_movement из оригинала (рывки 200/110, гейты, приоритет баланса)
2026-09-25 mov: zr 1.6 в дефолт (трим по полу, подобран бисекцией)
2026-09-25 док: итоги WASD/BT — c_movement-порт, HC-05 на COM13, уроки по нолю и шкале
2026-09-28 mov: ZR_RATE 1 (ноль не срывается при взводе), плавная передача хода в WASD (fade по |pid|)
2026-09-28 mov: фазовый гейт езды по rate — рывок в своей фазе качки, в чужой — держим ход
2026-09-28 док: контекст сессии для продолжения — WASD/BT, фазовый гейт не проверен
2026-09-28 tumbller: новая прошивка по схеме Elegoo Tumbller — стоит, ездит WASD, поворачивает
    Исследование проверенных проектов (reports/, research_notes/) показало один
    шаблон: PD угла + PI скорости/положения по энкодерам + поворот, ноль фиксирован,
    езда — цель внутри интеграла положения. gyrobot_tumbller построен по нему:
    - стойка: kp 20, kd 0.5, ksp 8, ksi 0.25, мёртвая зона 6/4
    - езда: симметричная рампа + bleed (тормозит там, где отпустили)
    - п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
2026-09-28 tumbller: мягкая остановка после W/S (bleed 20, dec 0.45), чистка режимов поворота
    - bleed 40 возвращал память положения за ~0.5 с — рывок, качка и откат до −9;
    20 + более мягкая рампа торможения убирают тряску, проезд чуть длиннее
    - из кода убраны неудачные режимы поворота (заморозка контура, адаптивный tba,
    PI колёс с общей частью); pvt теперь вкл/выкл поворота по колёсам
    - tools/stopstat.py — разбор остановок по ло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
2026-09-29 док: плата прошита 835385b
2026-09-29 чистка проекта: одна прошивка, README, батники в корне
    - удалены старые прошивки gyrobot_mov и gyrobot_v5 и их спеки/планы (есть в истории)
    - wasd.bat и новый flash.bat в корне; flash.ps1 теперь заливает gyrobot_tumbller на COM10
    - README.md: быстрый старт, прошивка, установка, параметры, неполадки, структура
    - документация в docs/: STATUS.md (журнал), sessions/, research/, схема помечена устаревшей
    - talk.py по умолчанию на COM13 (Bluetooth, без ресета плат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
2026-09-29 README: когда нужен flash.bat
2026-09-29 wasd: кроссплатформенный клиент (pygame-окно, автопоиск порта), запуск для Windows/macOS/Linux
    - клавиши через окно pygame: одинаково на Windows, macOS, Linux (X11/Wayland),
    без прав доступа, по физическим клавишам; стрелки тоже работают; потеря фокуса = стоп
    - автопоиск порта: опрос Bluetooth-портов командой p, найденный запоминается
    - в окне связь, нажатые клавиши, наклон, скорость, поворот; переподключение
    - wasd.sh (Linux), wasd.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
2026-09-29 wasd: сам ставит pygame/pyserial; при запрете pip — своё окружение tools/.venv
2026-09-29 wasd: на Linux не ставить пакеты, а показать команду для дистрибутива и ждать установки
2026-09-29 README: PIN HC-05 — 1234
2026-09-29 wasd: закрывает повисший прошлый клиент, чистый выход по сигналам, причина неудачи по каждому порту
2026-09-29 docs: схема подключения камеры OpenMV H7 Plus (+WiFi-шилд) к гироботу
2026-09-30 дрожь стоя: замеры, программных резервов нет; tools/standstat.py
2026-09-30 чистка прошивки: убраны step, vAF/vBF, pvt (ОЗУ 71% → 39%); итоги опытов с торможением
2026-09-30 настройки в EEPROM: save / defaults, защита от устаревших после перепрошивки; tele вместо s
    - save — все настраиваемые параметры в память робота, defaults — заводские и очистка
    - вместе с настройками хранится отпечаток заводских значений прошивки: если
    после перепрошивки они другие, сохранённое не применяется
    - команда телеметрии s никогда не срабатывала (s — это WASD), теперь tele 0/1
2026-09-30 спека: одометрия, карта и возврат домой
2026-09-30 план: одометрия, карта и возврат домой
2026-09-30 odo: одометрия (энкодеры + гироскоп), команда home, px/py/ph в телеметрии
2026-09-30 nav: возврат домой по прямой (TURN/DRIVE/FACE), команды h/x, knt/knd/ntol
2026-09-30 wasd: модуль карты (поза, след, пересчёт в экран) с тестами
2026-09-30 wasd: карта пути, H — домой, R — дом здесь, C — стереть след
2026-09-30 odo: MM_PER_CNT по рулетке (0.694 мм/имп), скорость в клиенте в честных см/с
2026-09-30 nav: поворот на месте и доворот только когда робот почти стоит; раньше тормозит к дому
2026-09-30 nav: демпфер поворота плавно гаснет со скоростью (без дёрганья), стоп с учётом тормозного пути
2026-09-30 nav: доворот без рывков (проверка скорости один раз), поворот на месте сразу после отпускания W/S
2026-09-30 nav: допуск доворота дома 2° (живой ftol, сохраняется)
2026-09-30 README и журнал: карта, возврат домой (H/R/C), параметры knt/knd/ntol/ftol, калибровка энкодера
2026-09-30 nav: возврат ограничен 30 с (стена, пропал Bluetooth); README: энкодер ~285 имп/об, скорость в мм/с
2026-10-06 камера: приём строк с OpenMV по программному UART (D12), тест провода tools/openmv/uart_test.py
2026-10-06 камера: стример с таймаутом Wi-Fi, сообщениями и светодиодами; пароль в wifi_config.py (не в git)
2026-10-06 камера: стример досылает кадр целиком, JPEG 60, автопереподключение страницы
2026-10-06 камера: стример ждёт клиентов с таймаутом; тесты wifi_test/server_test
2026-10-08 камера: таймаут 3 с на клиента — молчащее соединение больше не вешает стример
2026-10-08 камера: стример сам перезагружается при любом сбое и пропаже Wi-Fi, причина в last_error.txt, чистка памяти
2026-10-08 wasd: видео с камеры OpenMV в окне клиента (автопоиск в сети, переподключение); README про камеру
2026-10-08 камера: hand_detect работает с новой прошивкой (pixels/rect — значения, не методы) — это роняло поток при руке в кадре; ошибка распознавания больше не роняет стример
2026-10-08 камера: убрано распознавание рук из стримера — только видеопоток
2026-10-08 ноль под камеру: az −10.5 по умолчанию; журнал: камера, стример, подбор с камерой
2026-10-08 за красным мячом: камера ищет мяч и шлёт роботу смещение/размер (19200), режим g в прошивке, F в клиенте; main_ball.py вместо main_stream.py
2026-10-09 за мячом: центр мяча по рамке (поле пятна было не центром), масштаб 0.18 °/пикс и дистанция по замеру, фильтр помех UART, причина сбоя камеры на /status
2026-10-09 журнал: за красным мячом — замеры и грабли прошивки камеры
2026-10-09 за мячом: второй диапазон цвета — мяч в тени (/thr2)
2026-10-09 README: шпаргалка — команды робота и настройка цвета мяча на камере по шагам
